lucasd92/modulo_adquisidor/Capturas/Frontal v1-70 print.png

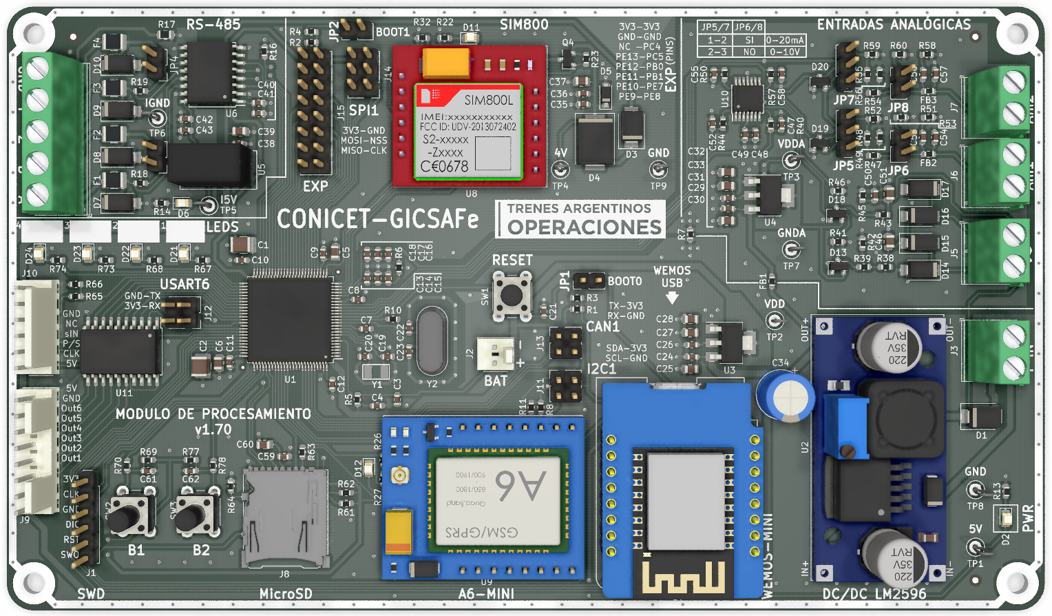
Capturas/Frontal v1-70 print.png
