lucasd92/modulo_adquisidor/Capturas/Perspectiva v1-70 print.png

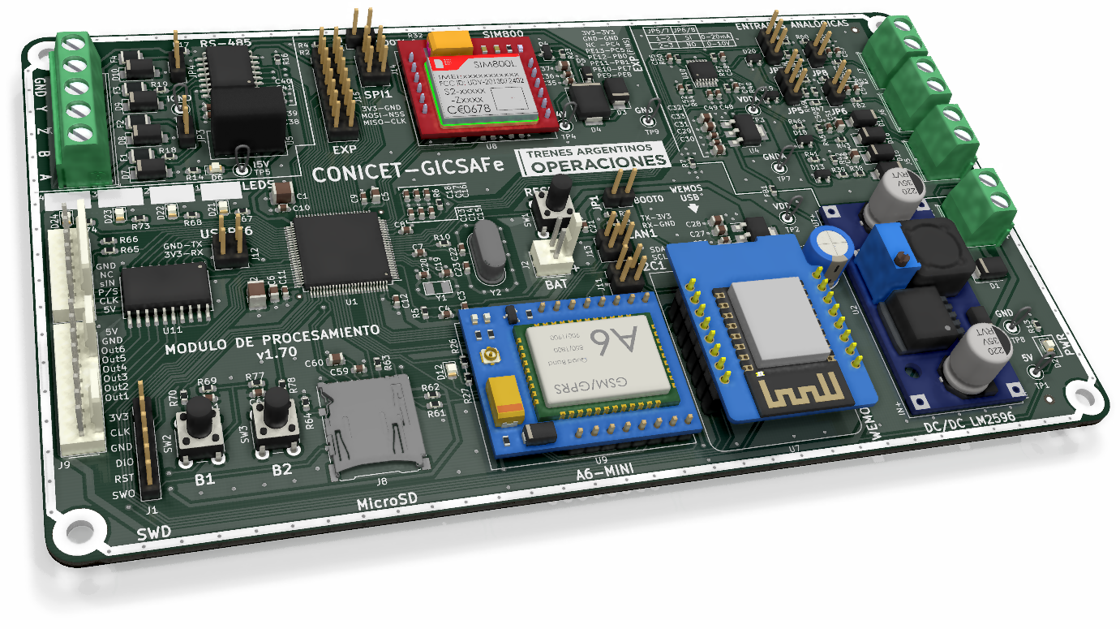
Capturas/Perspectiva v1-70 print.png
