lucasd92/modulo_adquisidor/Capturas/5v.jpg

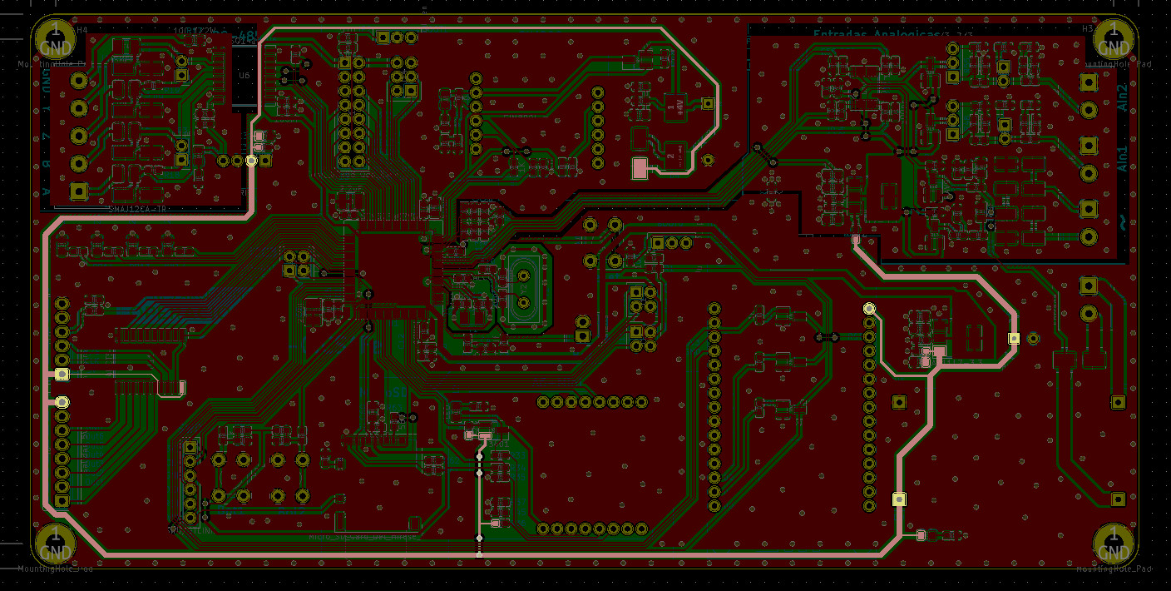
Capturas/5v.jpg
