lucasd92/modulo_adquisidor/Capturas/Frontal v1-61.jpg

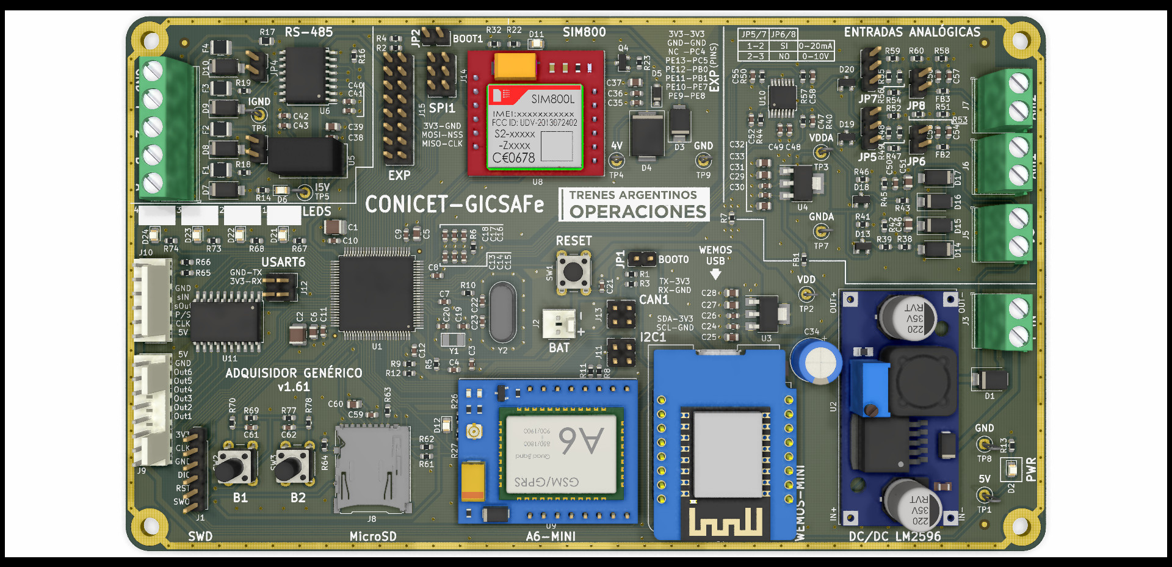
Capturas/Frontal v1-61.jpg
