lucasd92/modulo_adquisidor/Capturas/Trasero v1-1.jpg

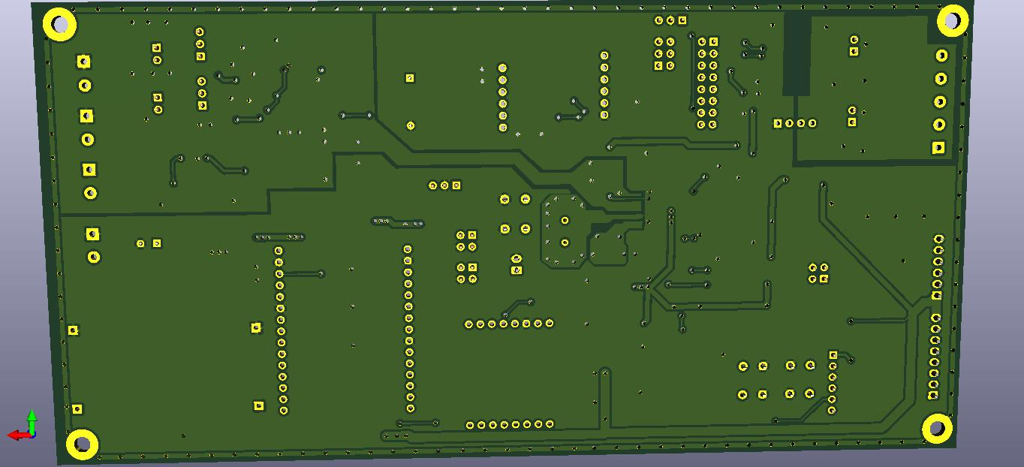
Capturas/Trasero v1-1.jpg
