lucasd92/modulo_adquisidor/Capturas/Trasero v1-3.jpg

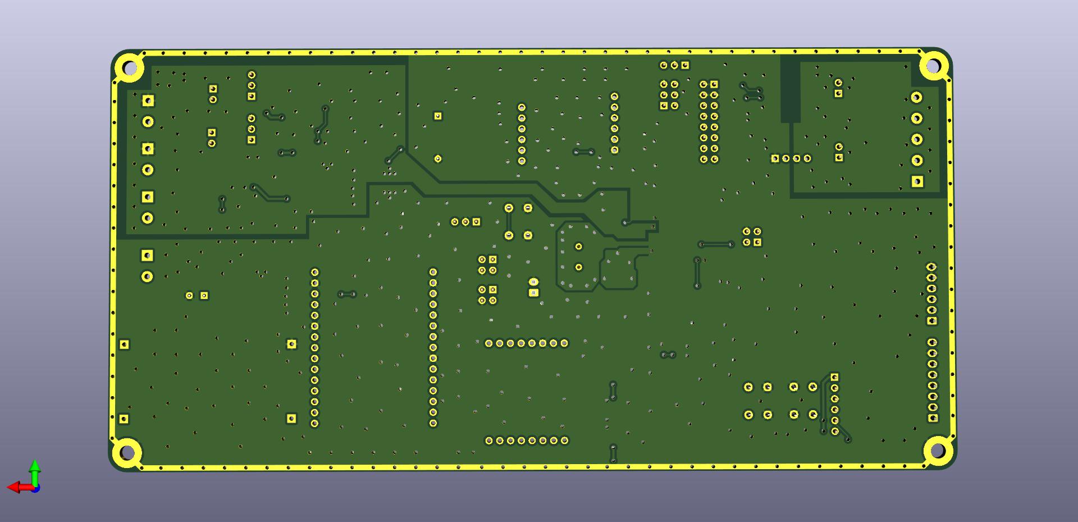
Capturas/Trasero v1-3.jpg
