lucasd92/modulo_adquisidor/Capturas/Trasero v1.jpg

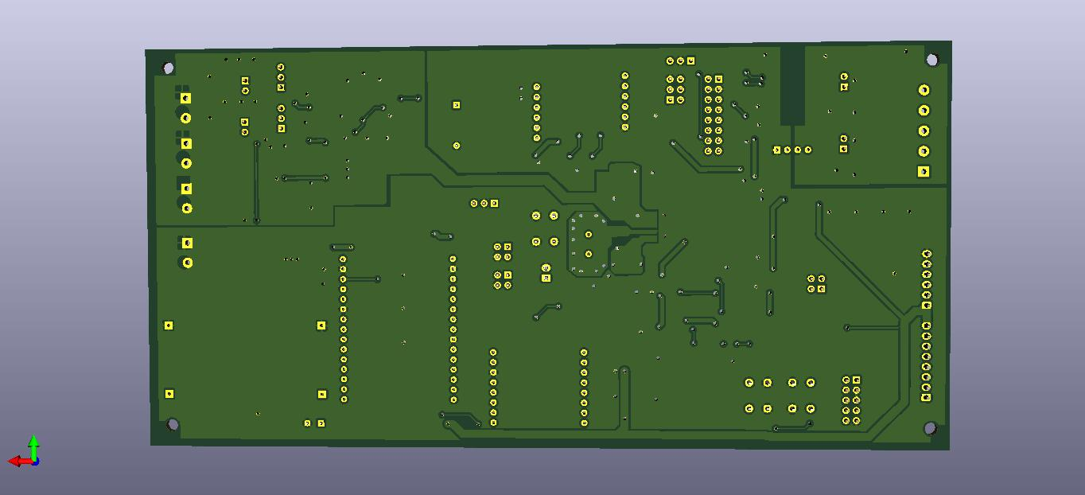
Capturas/Trasero v1.jpg
