lucasd92/modulo_adquisidor/Capturas/vcc.jpg

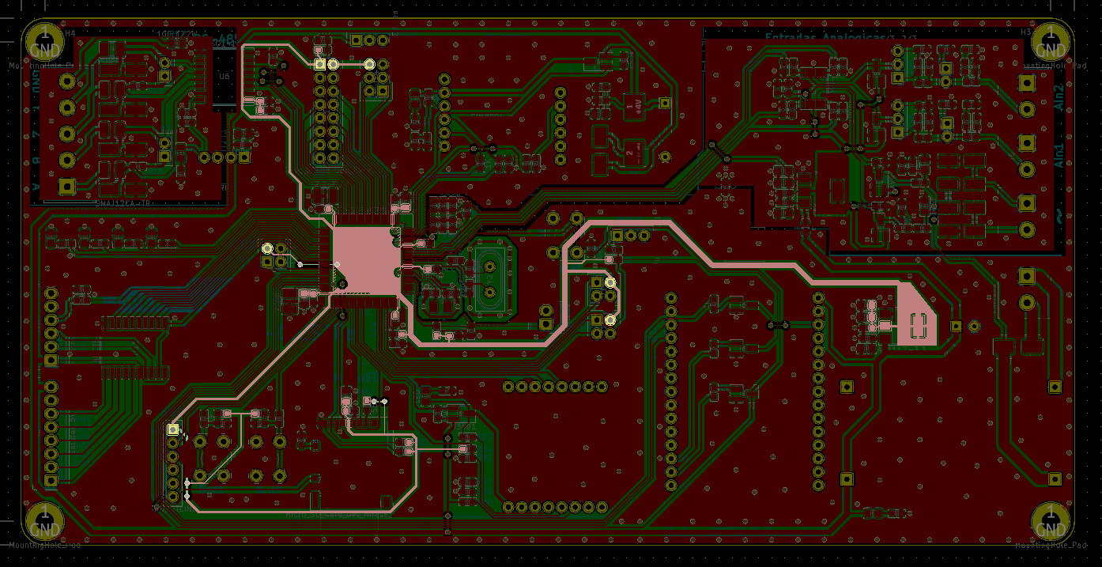
Capturas/vcc.jpg
