lucasd92/modulo_adquisidor/BOM.xlsx

Eeschema (5.0.2)-1
Component Count: | 212
Ref | Qty | Value | Part | Footprint | Column1 | Datasheet | Description | Vendor
C1, C2 | 2 | 2.2uF | C | Capacitor_SMD:C_1210_3225Metric | 478-2402-1-ND | https://www.digikey.com/product-detail/en/avx-corporation/TPSB475K020R1000/478-2402-1-ND/678570 | Unpolarized capacitor
C3, C15, C17, C40, C42, C48 | 6 | 1Uf | C | Capacitor_SMD:C_0603_1608Metric | 1276-1019-1-ND | https://www.digikey.com/product-detail/en/samsung-electro-mechanics/CL10B105KO8NNNC/1276-1019-1-ND/3889105 | Unpolarized capacitor
C4, C7, C8, C9, C10, C11, C12, C14, C16, C21, C24, C26, C29, C31, C38, C41, C43, C44, C45, C47, C49, C50, C52, C55,C58, C59, C61, C62 | 28 | 100nF | C | Capacitor_SMD:C_0603_1608Metric | 1276-1000-1-ND | https://www.digikey.com/product-detail/en/samsung-electro-mechanics/CL10B104KB8NNNC/1276-1000-1-ND/3889086 | Unpolarized capacitor
C5, C6 | 2 | 4.7uF | C | Capacitor_SMD:C_0805_2012Metric | 445-14527-1-ND | https://www.digikey.com/product-detail/en/tdk-corporation/C2012X7R1A475K085AC/445-14527-1-ND/3956193 | Unpolarized capacitor
C13, C18 | 2 | 10nF | C | Capacitor_SMD:C_0603_1608Metric | 1276-1009-1-ND | https://www.digikey.com/product-detail/en/samsung-electro-mechanics/CL10B103KB8NNNC/1276-1009-1-ND/3889095 | Unpolarized capacitor
C19, C20 | 2 | 1.5pF | C | Capacitor_SMD:C_0603_1608Metric | 311-1737-1-ND | https://www.digikey.com/product-detail/es/yageo/CC0603BRNPO9BN1R5/311-1737-1-ND/5195639 | Unpolarized capacitor
C22, C23 | 2 | 20pF | C | Capacitor_SMD:C_0603_1608Metric | 311-3924-1-ND | https://www.digikey.com/product-detail/en/yageo/CC0603GRNPO9BN200/311-3924-1-ND/8025013 | Unpolarized capacitor
C25, C27, C28, C30, C32, C33, C37, C39, C46, C51, C60 | 11 | 10uF | C | Capacitor_SMD:C_0805_2012Metric | 490-10498-1-ND | https://www.digikey.com/product-detail/en/murata-electronics-north-america/GRM21BC81C106KE15L/490-10498-1-ND/5026423 | Unpolarized capacitor
C34 | 1 | 820uF 10V | CP | Capacitor_THT:CP_Radial_D8.0mm_P3.50mm | 399-14115-ND | https://www.digikey.com/product-detail/en/kemet/A755KS827M1AAAE014/399-14115-ND/6196460 | Polarized capacitor
C35 | 1 | 10p | C | Capacitor_SMD:C_0603_1608Metric | 732-7760-1-ND | https://www.digikey.com/product-detail/en/wurth-electronics-inc/885012006017/732-7760-1-ND/5454387 | Unpolarized capacitor
C36 | 1 | 33p | C | Capacitor_SMD:C_0603_1608Metric | 478-10278-1-ND | https://www.digikey.com/product-detail/en/avx-corporation/06033A330JAT2A/478-10278-1-ND/6797495 | Unpolarized capacitor
C53, C56 | 2 | 470pF | C | Capacitor_SMD:C_0603_1608Metric | 1276-1094-1-ND | https://www.digikey.com/product-detail/en/samsung-electro-mechanics/CL10B471KB8NNNC/1276-1094-1-ND/3889180 | Unpolarized capacitor
C54, C57 | 2 | 1nF | C | Capacitor_SMD:C_0603_1608Metric | 1276-1018-1-ND | https://www.digikey.com/product-detail/en/samsung-electro-mechanics/CL10B102KB8NNNC/1276-1018-1-ND/3889104 | Unpolarized capacitor
D1, D3 | 2 | S5JB-R5G | 1N4007 | Diode_SMD:D_SMB | S5JBR5GCT-ND | https://www.digikey.com/product-detail/en/taiwan-semiconductor-corporation/S5JB-R5G/S5JBR5GCT-ND/7358545 | 1000V 1A General Purpose Rectifier Diode, DO-41
D2, D6, D11, D12, D21, D22, D23, D24 | 8 | LED | LED | LED_SMD:LED_0805_2012Metric |  | ~ | Light emitting diode
D4 | 1 | B340 | B340 | Diode_SMD:D_SMC | B340-FDICT-ND | https://www.digikey.com/product-detail/en/diodes-incorporated/B340-13-F/B340-FDICT-ND/768811 | 40V 3A Schottky Barrier Rectifier Diode, SMC
D5 | 1 | BZT52-B5V1X | ZPDxx | Diode_SMD:D_SOD-123 | 1727-7681-1-ND | https://www.digikey.com/product-detail/en/nexperia-usa-inc/BZT52-B5V1X/1727-7681-1-ND/8640662 | 500mW Zener Diode, DO-35
D7, D8, D9, D10 | 4 | SMAJ12CA-TR | D_TVS | Diode_SMD:D_SMA | 497-2996-1-ND | https://www.digikey.com/product-detail/en/stmicroelectronics/SMAJ12CA-TR/497-2996-1-ND/634854 | Bidirectional transient-voltage-suppression diode
D13, D18, D19, D20 | 4 | BAV99 | BAV99 | Package_TO_SOT_SMD:SOT-23 | BAV99LT1GOSCT-ND | https://www.digikey.com/product-detail/en/on-semiconductor/BAV99LT1G/BAV99LT1GOSCT-ND/917821 | BAV99 High-speed switching diodes
D14, D15, D16, D17 | 4 | MRA4007T3G | MRA4007T3G | Diode_SMD:D_SMA | 641-1018-1-ND | https://www.digikey.com/product-detail/en/comchip-technology/CGRA4007-G/641-1018-1-ND/1121140 | 1000V 1A General Purpose Rectifier Diode, SMA(DO-214AC)
F1, F2, F3, F4 | 4 | USMF020 | Fuse | Resistor_SMD:R_1210_3225Metric | MF-USMF020-2CT-ND | https://www.digikey.com/product-detail/es/bourns-inc/MF-USMF020-2/MF-USMF020-2CT-ND/1014928 | Fuse
FB1 | 1 | Ferrite_Bead | Ferrite_Bead | Resistor_SMD:R_0603_1608Metric | 445-2205-1-ND | https://www.digikey.com/product-detail/en/tdk-corporation/MPZ1608S601ATA00/445-2205-1-ND/765103 | Ferrite bead
FB2, FB3 | 2 | MMZ1608B601C | Ferrite_Bead_Small | Resistor_SMD:R_0603_1608Metric | 445-2166-1-ND | https://www.digikey.com/product-detail/en/tdk-corporation/MMZ1608B601CTAH0/445-2166-1-ND/765197 | Ferrite bead, small symbol
J1 | 1 | SWD/STLINK | Conn_01x06_Male | Connector_PinHeader_2.54mm:PinHeader_1x06_P2.54mm_Vertical |  | ~
J2 | 1 | Bateria | Conn_01x02_Male | Connector_Molex:Molex_KK-254_AE-6410-02A_1x02_P2.54mm_Vertical |  | ~
J3 | 1 | Entrada 24V | Screw_Terminal_01x02 | Propios:TerminalBlock_Phoenix_PT-1,5-2-5.0-H_1x02_P5.00mm_Horizontal_con_modelo3d |  | ~
J4 | 1 | RS-485 | Screw_Terminal_01x05 | Propios:TerminalBlock_Phoenix_PT-1,5-5-5.0-H_1x05_P5.00mm_Horizontal_con_modelo3d |  | ~
J5 | 1 | TV_6V | Screw_Terminal_01x02 | Propios:TerminalBlock_Phoenix_PT-1,5-2-5.0-H_1x02_P5.00mm_Horizontal_con_modelo3d |  | ~
J6 | 1 | AN1 | Screw_Terminal_01x02 | Propios:TerminalBlock_Phoenix_PT-1,5-2-5.0-H_1x02_P5.00mm_Horizontal_con_modelo3d |  | ~
J7 | 1 | AN2 | Screw_Terminal_01x02 | Propios:TerminalBlock_Phoenix_PT-1,5-2-5.0-H_1x02_P5.00mm_Horizontal_con_modelo3d |  | ~
J8 | 1 | Micro_SD | Micro_SD_Card_Det_Hirose_DM3AT | Propios:microSD_HC_Hirose_DM3AT-SF-PEJM5 | HR1964CT-ND | https://www.digikey.com/product-detail/es/hirose-electric-co-ltd/DM3AT-SF-PEJM5/HR1964CT-ND/2533566
J9 | 1 | Salidas 5V | Conn_01x08_Male | Connector_Molex:Molex_KK-254_AE-6410-08A_1x08_P2.54mm_Vertical |  | ~
J10 | 1 | entradas digitales | Conn_01x06_Male | Connector_Molex:Molex_KK-254_AE-6410-06A_1x06_P2.54mm_Vertical |  | ~
J11 | 1 | I2C1 | Conn_02x02_Odd_Even | Connector_PinHeader_2.54mm:PinHeader_2x02_P2.54mm_Vertical |  | ~
J12 | 1 | USART6 | Conn_02x02_Odd_Even | Connector_PinHeader_2.54mm:PinHeader_2x02_P2.54mm_Vertical |  | ~
J13 | 1 | CAN1 | Conn_02x02_Odd_Even | Connector_PinHeader_2.54mm:PinHeader_2x02_P2.54mm_Vertical |  | ~
J14 | 1 | SPI1 | Conn_02x03_Odd_Even | Connector_PinHeader_2.54mm:PinHeader_2x03_P2.54mm_Vertical |  | ~
J15 | 1 | Conn_02x08_Odd_Even | Conn_02x08_Odd_Even | Connector_PinHeader_2.54mm:PinHeader_2x08_P2.54mm_Vertical |  | ~
JP1, JP2 | 2 | Jumper_2_Open | Jumper_2_Open | Connector_PinHeader_2.54mm:PinHeader_1x02_P2.54mm_Vertical |  | ~ | Jumper, 2-pole, open
JP3, JP4 | 2 | Jumper | Jumper | Connector_PinHeader_2.54mm:PinHeader_1x02_P2.54mm_Vertical |  | ~ | Jumper, normally closed
JP5, JP7 | 2 | 1/3-2/3 | Jumper_3_Open | Connector_PinHeader_2.54mm:PinHeader_1x03_P2.54mm_Vertical |  | ~ | Jumper, 3-pole, both open
JP6, JP8 | 2 | I_meas | Jumper | Connector_PinHeader_2.54mm:PinHeader_1x02_P2.54mm_Vertical |  | ~ | Jumper, normally closed
Q1, Q2, Q3 | 3 | MMBT3904 | MMBT3904 | Package_TO_SOT_SMD:SOT-23 | MMBT3904TPMSCT-ND | https://www.digikey.com/product-detail/en/micro-commercial-co/MMBT3904-TP/MMBT3904TPMSCT-ND/717395 | 0.2A Ic, 40V Vce, Small Signal NPN Transistor, SOT-23
Q4, Q5 | 2 | AO3401 | BSS83P | Package_TO_SOT_SMD:SOT-23 | 785-1001-1-ND | https://www.digikey.com/product-detail/en/alpha-omega-semiconductor-inc/AO3401A/785-1001-1-ND/1855943 | -0.33A Id, -60V Vds, P-Channel MOSFET, SOT-23-3
R1, R2,R69, R77 | 4 | 10K | R | Resistor_SMD:R_0603_1608Metric | RMCF0603FT10K0CT-ND | https://www.digikey.com/product-detail/en/stackpole-electronics-inc/RMCF0603FT10K0/RMCF0603FT10K0CT-ND/1943057 | Resistor
R3, R4 | 2 | 510 | R | Resistor_SMD:R_0603_1608Metric | RMCF0603FT510RCT-ND | https://www.digikey.com/product-detail/en/stackpole-electronics-inc/RMCF0603FT510R/RMCF0603FT510RCT-ND/2418081 | Resistor
R5, R7, R9, R12, R28, R32, R33, R34, R35, R36, R37, R42, R45, R49, R56, R64 | 17 | 0 | R | Resistor_SMD:R_0603_1608Metric | RMCF0603ZT0R00CT-ND | https://www.digikey.com/product-detail/en/stackpole-electronics-inc/RMCF0603ZT0R00/RMCF0603ZT0R00CT-ND/1943218 | Resistor
R6 | 1 | 47 | R | Resistor_SMD:R_0603_1608Metric | RMCF0603FT47R0CT-ND | https://www.digikey.com/product-detail/en/stackpole-electronics-inc/RMCF0603FT47R0/RMCF0603FT47R0CT-ND/1942954 | Resistor
R8, R11 | 2 | 4K7 | R | Resistor_SMD:R_0603_1608Metric | RMCF0603FT4K70CT-ND | https://www.digikey.com/product-detail/en/stackpole-electronics-inc/RMCF0603FT4K70/RMCF0603FT4K70CT-ND/1943033 | Resistor
R10 | 0 | CALCULAR | R | Resistor_SMD:R_0603_1608Metric |  | ~ | Resistor
R15, R20, R21, R24, R25, R29,R13, R14, R22,R27,R70, R78 | 12 | 1K | R | Resistor_SMD:R_0603_1608Metric | RMCF0603FT1K00CT-ND | https://www.digikey.com/product-detail/en/stackpole-electronics-inc/RMCF0603FT1K00/RMCF0603FT1K00CT-ND/1942996 | Resistor
R16, R30, R31 | 3 | 5K6 | R | Resistor_SMD:R_0603_1608Metric | RMCF0603FT5K60CT-ND | https://www.digikey.com/product-detail/en/stackpole-electronics-inc/RMCF0603FT5K60/RMCF0603FT5K60CT-ND/2418099 | Resistor
R17 | 1 | 100 1/2W | R | Resistor_SMD:R_0805_2012Metric | P100ADCT-ND | https://www.digikey.com/product-detail/en/panasonic-electronic-components/ERJ-P06J101V/P100ADCT-ND/525436 | Resistor
R18, R19 | 2 | 120 | R | Resistor_SMD:R_0603_1608Metric | RMCF0603FT120RCT-ND | https://www.digikey.com/product-detail/en/stackpole-electronics-inc/RMCF0603FT120R/RMCF0603FT120RCT-ND/1942967 | Resistor
R23, R26 | 2 | 150k | R | Resistor_SMD:R_0603_1608Metric | RMCF0603FT150KCT-ND | https://www.digikey.com/product-detail/en/stackpole-electronics-inc/RMCF0603FT150K/RMCF0603FT150KCT-ND/1943124 | Resistor
R38, R39, R41, R47, R48, R52, R54, R55, R59 | 9 | 15k | R | Resistor_SMD:R_0603_1608Metric | RMCF0603FG15K0CT-ND | https://www.digikey.com/product-detail/en/stackpole-electronics-inc/RMCF0603FG15K0/RMCF0603FG15K0CT-ND/4425035 | Resistor
R40, R44, R50, R57 | 4 | 1.5k | R | Resistor_SMD:R_0603_1608Metric | RMCF0603FT1K50CT-ND | https://www.digikey.com/product-detail/en/stackpole-electronics-inc/RMCF0603FT1K50/RMCF0603FT1K50CT-ND/1943003 | Resistor
R43 | 1 | 47k | R | Resistor_SMD:R_0603_1608Metric | RMCF0603FT47K0CT-ND | https://www.digikey.com/product-detail/en/stackpole-electronics-inc/RMCF0603FT47K0/RMCF0603FT47K0CT-ND/1943099 | Resistor
R46 | 1 | 12k | R | Resistor_SMD:R_0603_1608Metric | RMCF0603FT12K0CT-ND | https://www.digikey.com/product-detail/en/stackpole-electronics-inc/RMCF0603FT12K0/RMCF0603FT12K0CT-ND/1943062 | Resistor
R51, R58 | 2 | 4.7 | R | Resistor_SMD:R_0603_1608Metric | 2019-RK73H1JTTD4R70FCT-ND | https://www.digikey.com/product-detail/en/koa-speer-electronics-inc/RK73H1JTTD4R70F/2019-RK73H1JTTD4R70FCT-ND/9846919 | Resistor
R53, R60, R65 | 3 | 220 | R | Resistor_SMD:R_0603_1608Metric | RMCF0603FT220RCT-ND | https://www.digikey.com/product-detail/en/stackpole-electronics-inc/RMCF0603FT220R/RMCF0603FT220RCT-ND/1942973 | Resistor
R61, R62, R63 | 3 | 56K | R | Resistor_SMD:R_0603_1608Metric | RMCF0603FT56K0CT-ND | https://www.digikey.com/product-detail/en/stackpole-electronics-inc/RMCF0603FT56K0/RMCF0603FT56K0CT-ND/2418092 | Resistor
R66 | 1 | 330 | R | Resistor_SMD:R_0603_1608Metric | RMCF0603FT330RCT-ND | https://www.digikey.com/product-detail/en/stackpole-electronics-inc/RMCF0603FT330R/RMCF0603FT330RCT-ND/1942981 | Resistor
R67, R68, R73, R74 | 4 | 260 | R | Resistor_SMD:R_0603_1608Metric | RMCF0603FT261RCT-ND | https://www.digikey.com/product-detail/en/stackpole-electronics-inc/RMCF0603FT261R/RMCF0603FT261RCT-ND/2417998 | Resistor
SW1, SW2, SW3 | 3 | SW_Push | SW_Push | Button_Switch_THT:SW_PUSH_6mm_H9.5mm |  |  | Push button switch, generic, two pins
U1 | 1 | STM32F407VGTx | STM32F407VGTx | Package_QFP:LQFP-100_14x14mm_P0.5mm | 497-11605-ND | https://www.digikey.com/product-detail/en/stmicroelectronics/STM32F407VGT6/497-11605-ND/2747117 | ARM Cortex-M4 MCU, 1024KB flash, 128KB RAM, 168MHz, 1.8-3.6V, 82 GPIO, LQFP-100
U2 | 1 | DC-DC_Step-Down | DC-DC_Step-Down | Propios:modulo_dc-dc-LM2596 |  | http://www.ti.com/lit/ds/symlink/lm2596.pdf | Basado en LM2596
U3, U4 | 2 | AZ1117-3.3 | AZ1117-3.3 | Package_TO_SOT_SMD:SOT-223-3_TabPin2 | AZ1117IH-3.3TRG1DICT-ND | https://www.digikey.com/product-detail/en/diodes-incorporated/AZ1117IH-3.3TRG1/AZ1117IH-3.3TRG1DICT-ND/5699682 | 1A 20V Fixed LDO Linear Regulator, 3.3V, SOT-89/SOT-223/TO-220/TO-252/TO-263
U5 | 1 | RFM-0505S | RFM-0505S | Propios:SIP4-RFM0505S | 945-3159-ND | https://www.digikey.com/product-detail/en/recom-power/RFM-0505S/945-3159-ND/8550767
U6 | 1 | ISO1412 | ISO1412 | Package_SO:SOIC-16W_7.5x10.3mm_P1.27mm | 296-53077-ND | https://www.digikey.com/product-detail/en/texas-instruments/ISO1412BDW/296-53077-ND/9860888
U7 | 1 | WeMos_mini | WeMos_mini | wemos:wemos-d1-mini-with-pin-header-and-connector |  | http://www.wemos.cc/Products/d1_mini.html | WeMos D1 mini
U8 | 1 | SIM800L_modulo | SIM800L_modulo | Propios:SIM800L_mod |  | http://mt-system.ru/sites/default/files/documents/sim800_hardware_design_v1.09.pdf | Módulo basado en sim80L de 12 pines
U9 | 1 | Modulo_A6_Mini | Modulo_A6_Mini | Propios:Modulo_A6_mini |  | https://www.makerfabs.com/desfile/files/A6_A7_A6C_datasheet-EN.pdf
U10 | 1 | MCP6L04T-E/ST | LMV324 | Package_SO:TSSOP-14_4.4x5mm_P0.65mm | MCP6L04T-E-STCT-ND | https://www.digikey.com/product-detail/en/microchip-technology/MCP6L04T-E-ST/MCP6L04T-E-STCT-ND/2060123 | Quad Low-Voltage Rail-to-Rail Output Operational Amplifier, SOIC-14/SSOP-14
U11 | 1 | 74HCT541 | 74HCT541 | Package_SO:SOIC-20W_7.5x12.8mm_P1.27mm | 296-14870-1-ND | https://www.digikey.com/product-detail/en/texas-instruments/SN74HCT541DWR/296-14870-1-ND/562554 | 8-bit Buffer/Line Driver 3-state outputs
Y1 | 1 | 32.768KHz | Crystal | Propios:Cristal 32KHz | XC2158CT-ND | https://www.digikey.com/product-detail/es/ecs-inc/ECS-.327-6-34QS-TR/XC2158CT-ND/6050766 | Two pin crystal
Y2 | 1 | 8MHz | Crystal | Crystal:Crystal_HC49-4H_Vertical | 887-1233-ND | https://www.digikey.com/product-detail/en/txc-corporation/9B-8.000MEEJ-B/887-1233-ND/2207653 | Two pin crystal
 | 1 |  | Componente Facundo |  | 828-1058-1-ND | https://www.digikey.com/product-detail/es/bosch-sensortec/BNO055/828-1058-1-ND/6136309
