lucasd92/modulo_adquisidor/3dshapes/ECS-.327-12.5-34B-C-TR--3DModel-STEP-40055.STEP

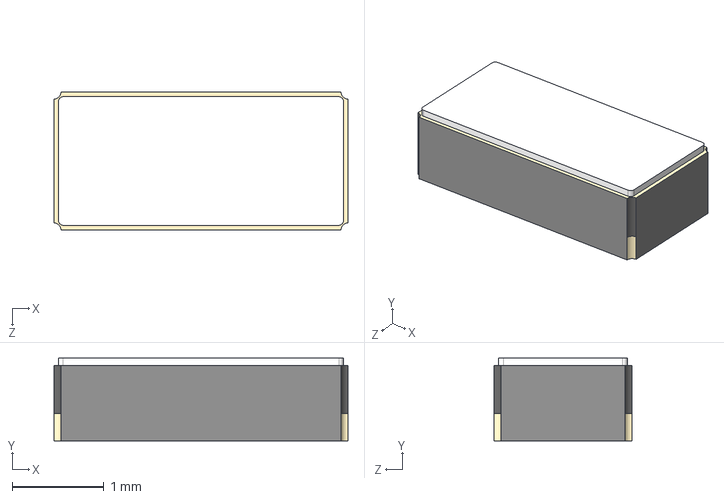
[picture p15: CAD file, 2019-09-19]
3dshapes/ECS-.327-12.5-34B-C-TR--3DModel-STEP-40055.STEP
3.20 x 0.9 x 1.50 mm
