lucasd92/modulo_adquisidor/Placa_base.pdf

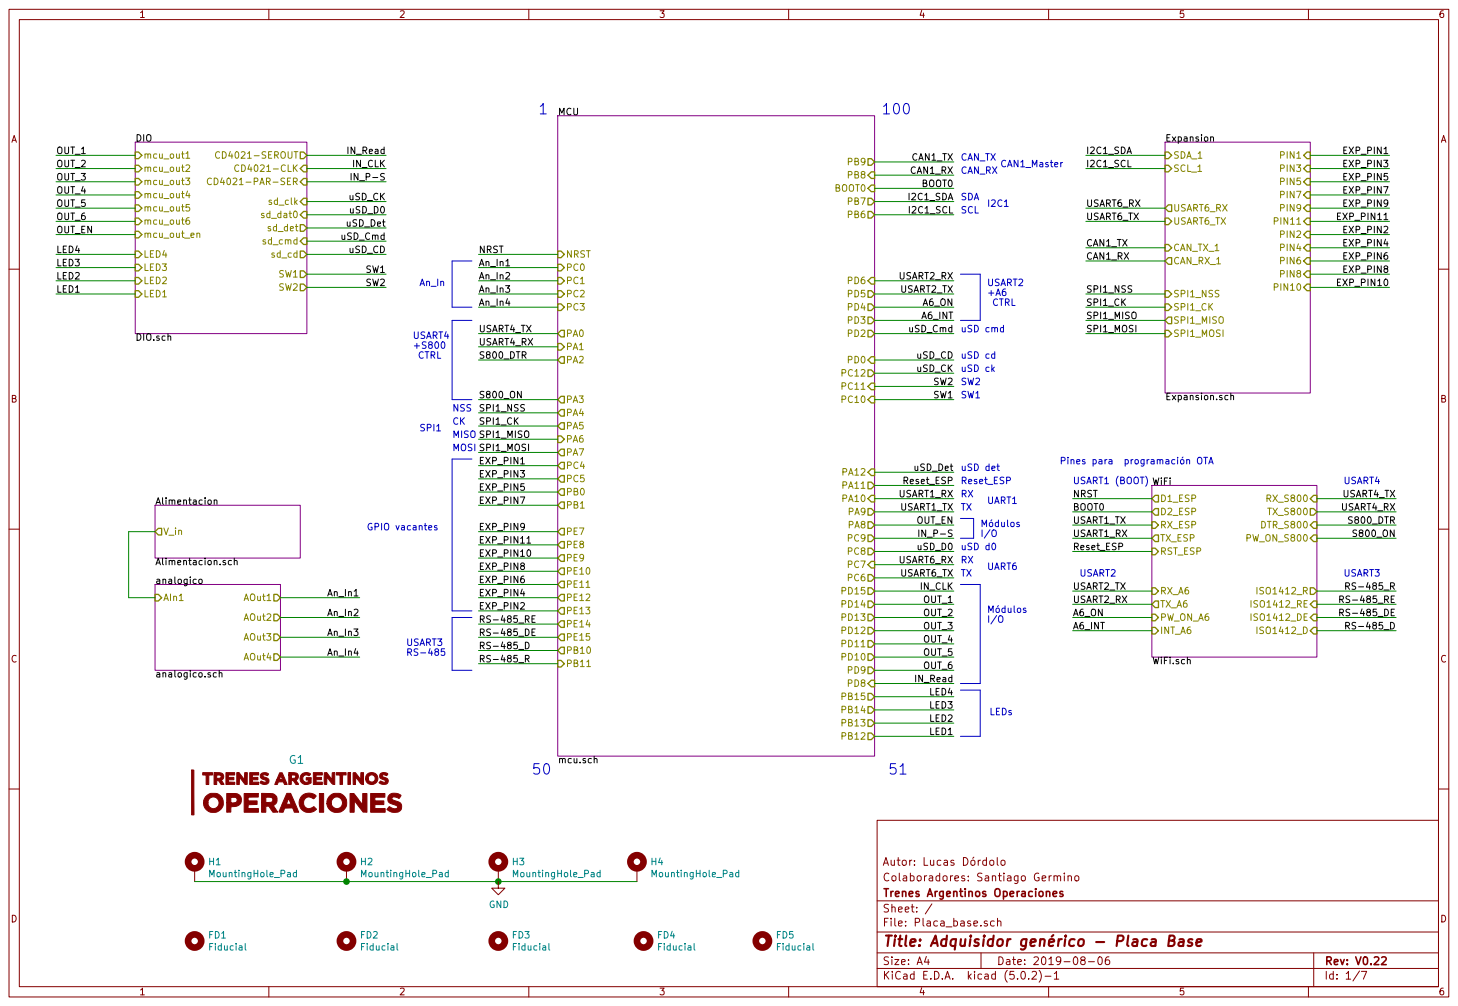
[picture p16: page 1]

A6_INT A6_ON
uSD ck uSD det uSD cd

Colaboradores: Santiago Germino Autor: Lucas Dórdolo

File: Placa_base.sch Sheet: / Trenes Argentinos Operaciones

Id: 1/7 Title: Adquisidor genérico - Placa Base

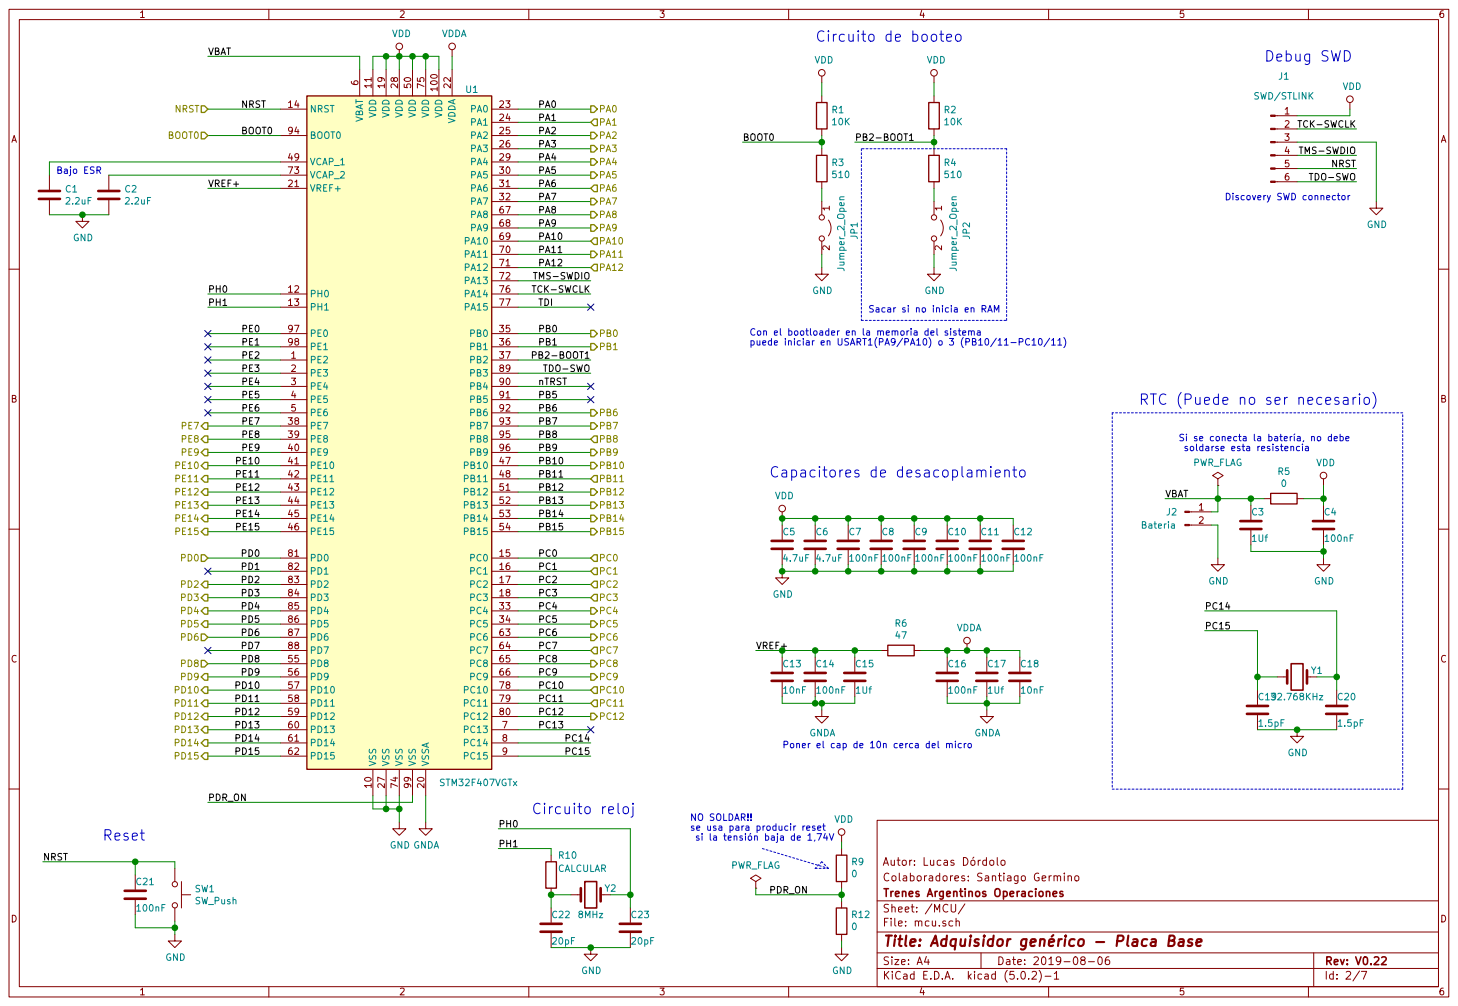
[picture p17: page 2]

nTRST PB5 PB6 PB7 PB8 PB9 TDI PA10 PA11 PA12 TMS-SWDIO
PC15 PC10 PC11 PC12 PC13 PC14 PC0 PC1 PC2 PC3 PC4 PC5 PC6 PC7 PC8 PC9 PB15 PB10 PB11 PB12 PB13 PB14 PB0 PB1 PB2-BOOT1 TDO-SWO

RTC (Puede no ser necesario)

Si se conecta la batería, no debe

10nF Poner el cap de 10n cerca del micro

se usa para producir reset
si la tensión baja de 1,74V

Colaboradores: Santiago Germino Autor: Lucas Dórdolo
File: mcu.sch Sheet: /MCU/ Trenes Argentinos Operaciones
0 GND
Id: 2/7 Title: Adquisidor genérico - Placa Base

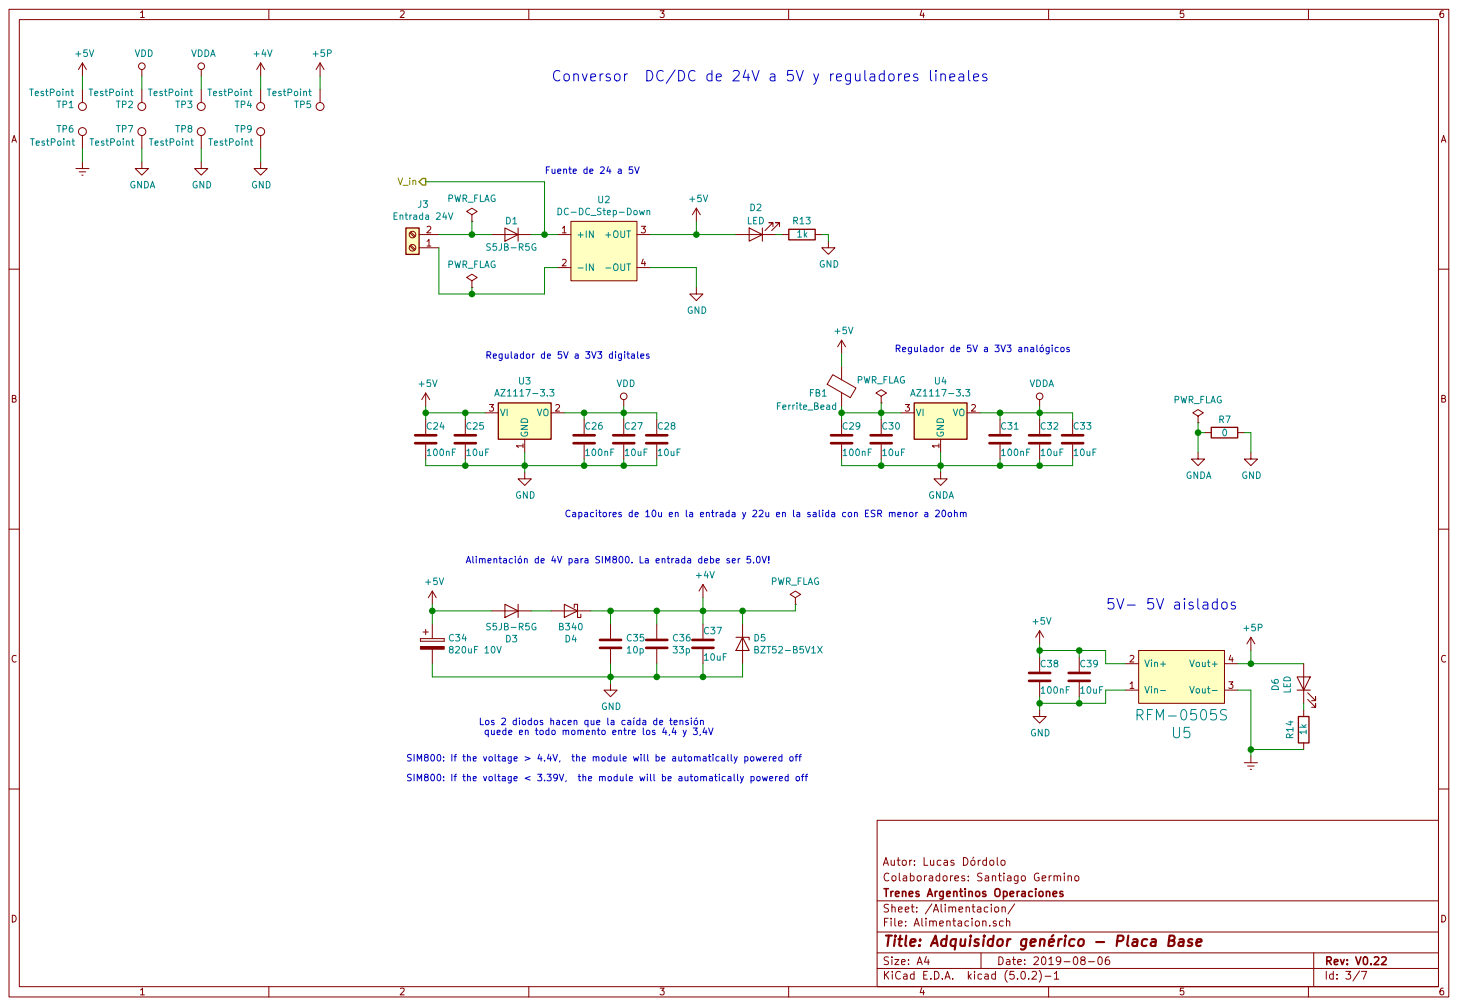
[picture p18: page 3]

Conversor DC/DC de 24V a 5V y reguladores lineales

Colaboradores: Santiago Germino Autor: Lucas Dórdolo GND

10uF SIM800: If the voltage > 4.4V, the module will be automatically powered off

Alimentación de 4V para SIM800. La entrada debe ser 5.0V!

SIM800: If the voltage < 3.39V, the module will be automatically powered off D4 B340 D3 S5JB-R5G

quede en todo momento entre los 4,4 y 3,4V C34

Los 2 diodos hacen que la caída de tensión

File: Alimentacion.sch Sheet: /Alimentacion/ Trenes Argentinos Operaciones

Id: 3/7 Title: Adquisidor genérico - Placa Base

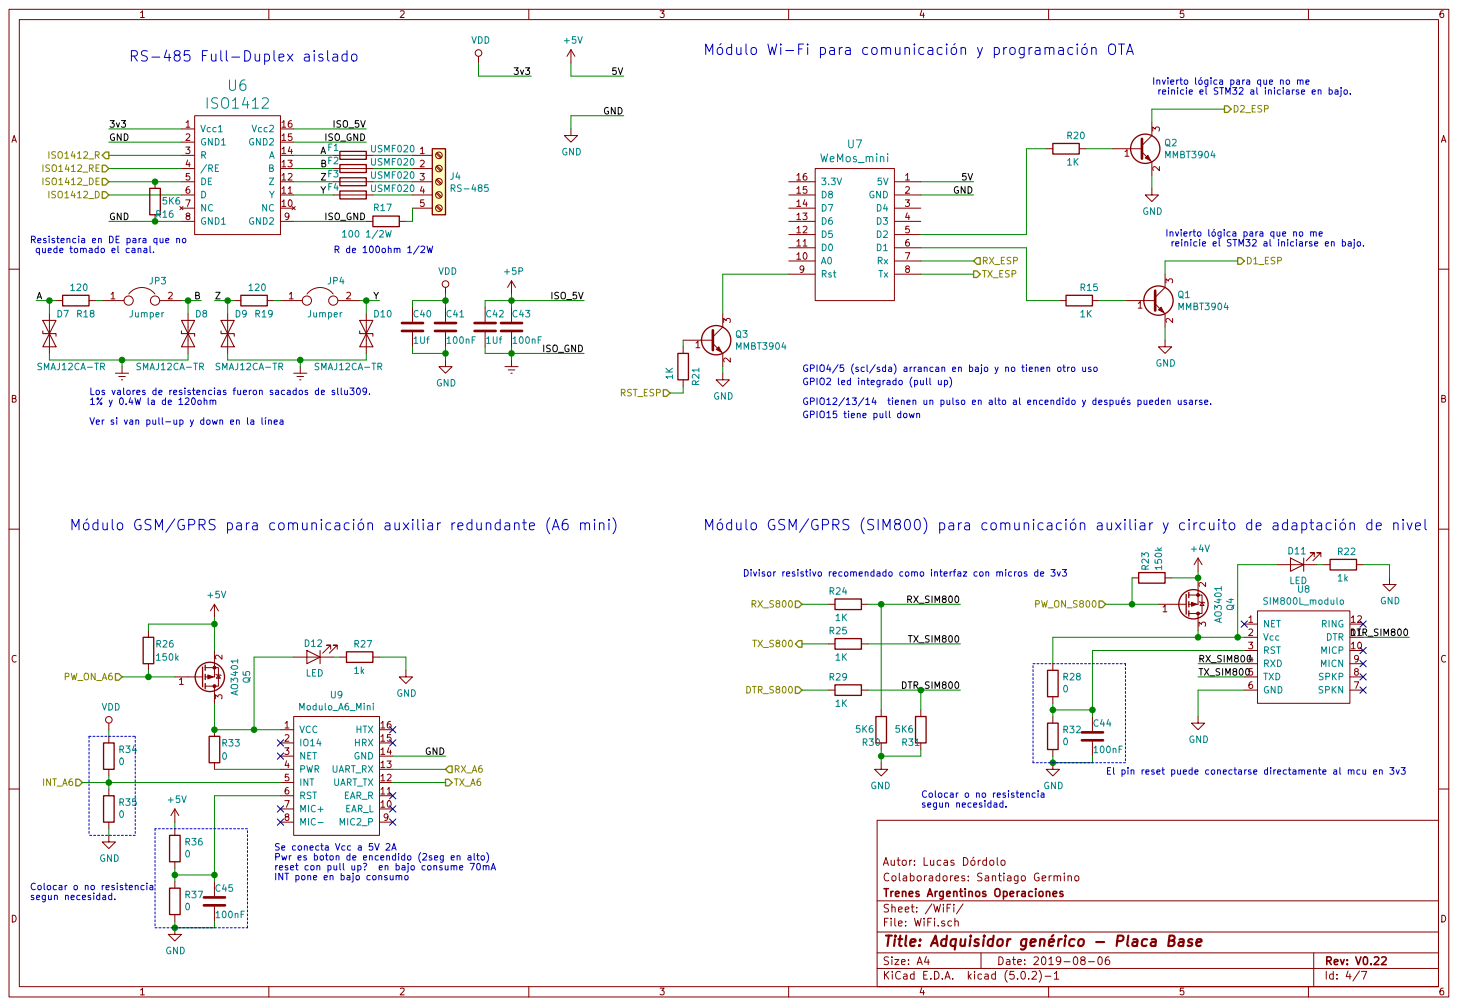
[picture p19: page 4]

RS-485 Full-Duplex aislado

Módulo Wi-Fi para comunicación y programación OTA

Invierto lógica para que no me
reinicie el STM32 al iniciarse en bajo. D1_ESP

GPIO12/13/14 tienen un pulso en alto al encendido y después pueden usarse.1

100 1/2W Resistencia en DE para que no

reinicie el STM32 al iniciarse en bajo.

Módulo GSM/GPRS (SIM800) para comunicación auxiliar y circuito de adaptación de nivel +5PC43

Los valores de resistencias fueron sacados de sllu309. 1% y 0.4W la de 120ohm

GPIO2 led integrado (pull up)

RX_SIM800 TX_SIM800 Divisor resistivo recomendado como interfaz con micros de 3v3

RX_SIM800 TX_SIM800 El pin reset puede conectarse directamente al mcu en 3v3 R24

Pwr es boton de encendido (2seg en alto)
reset con pull up? en bajo consume 70mA

Colaboradores: Santiago Germino Autor: Lucas Dórdolo

File: WiFi.sch Sheet: /WiFi/ Trenes Argentinos Operaciones

Id: 4/7 Title: Adquisidor genérico - Placa Base

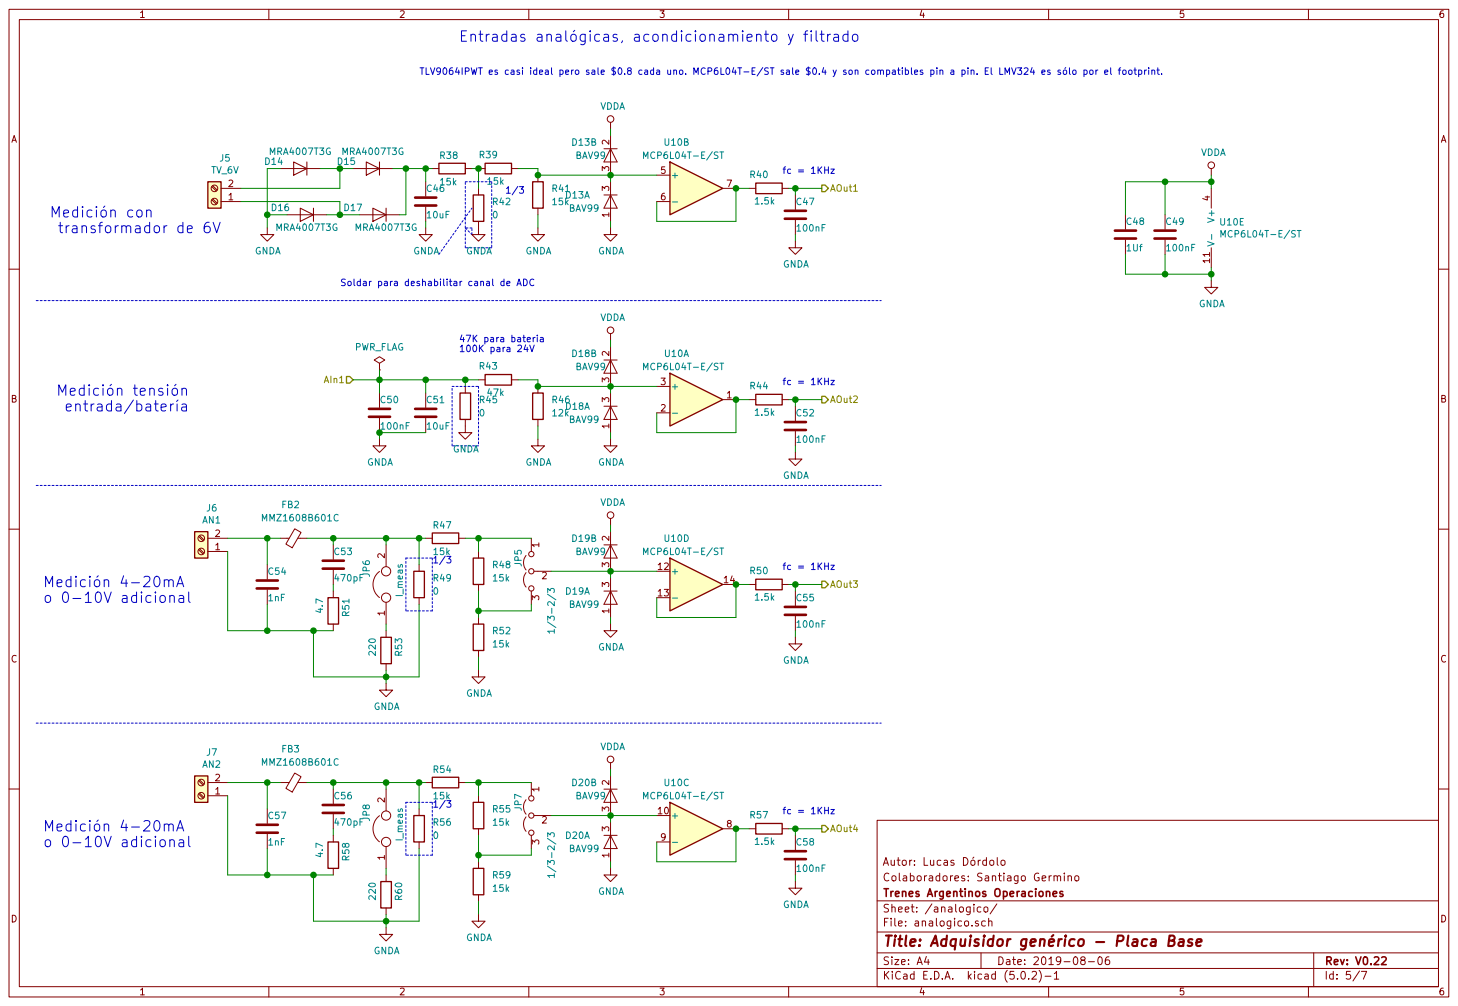
[picture p20: page 5]

Entradas analógicas, acondicionamiento y filtrado

1/3 AIn1
D17MRA4007T3G
0 Soldar para deshabilitar canal de ADC

Colaboradores: Santiago Germino Autor: Lucas Dórdolo

Trenes Argentinos Operaciones
Sheet: /analogico/
File: analogico.sch
Id: 5/7 Title: Adquisidor genérico - Placa Base

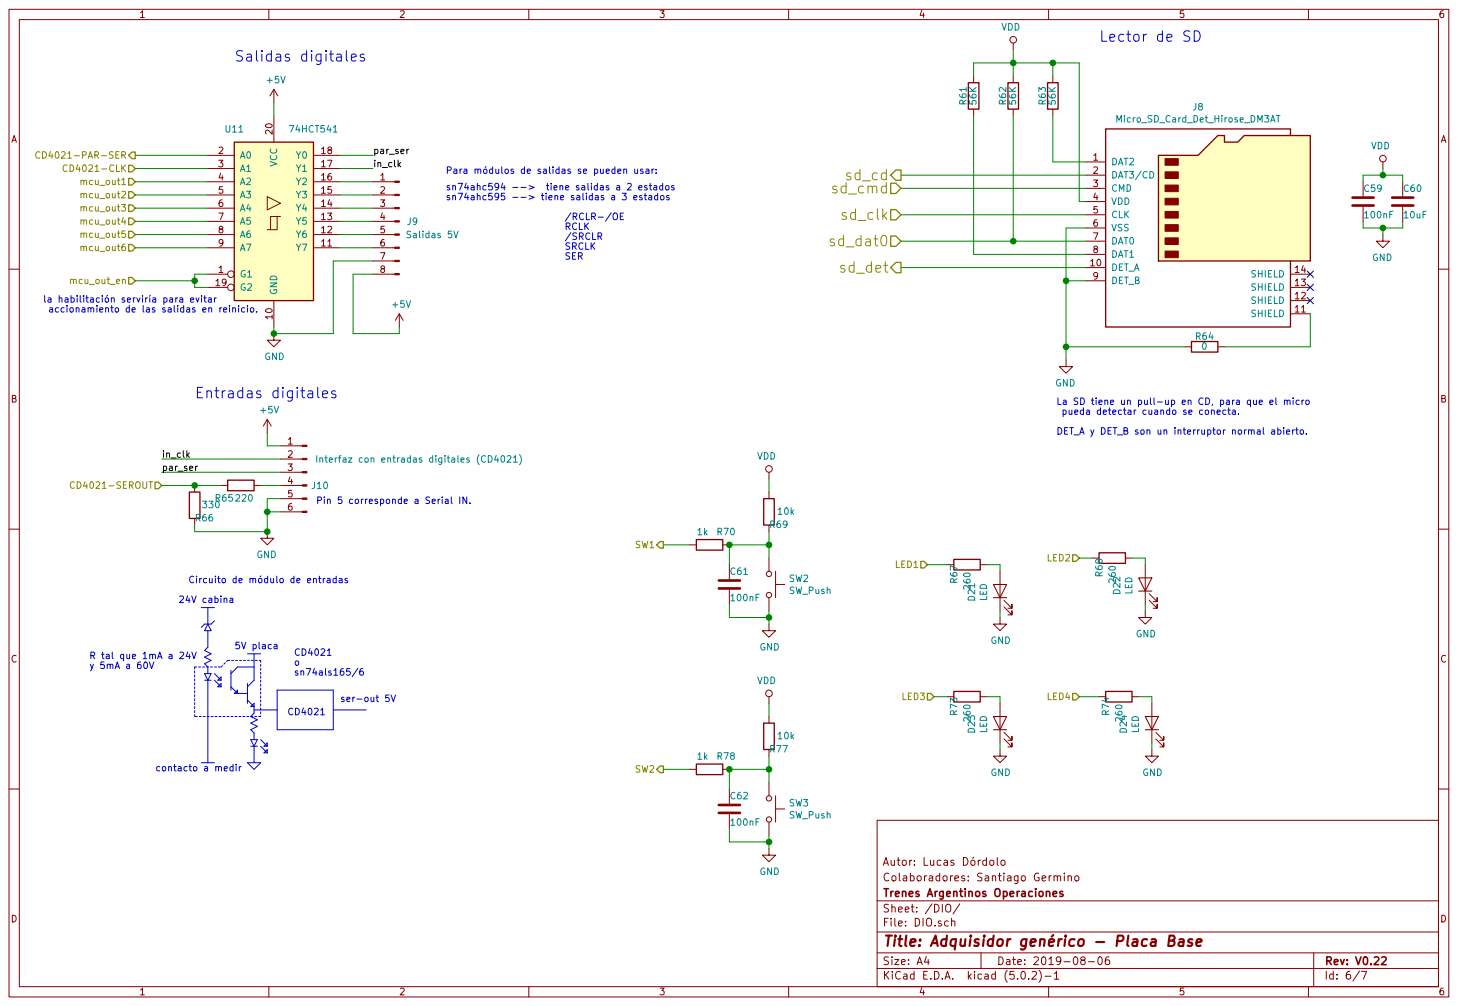
[picture p21: page 6]

10uF VDD GND Lector de SD

sn74ahc595 --> tiene salidas a 3 estados Para módulos de salidas se pueden usar: Circuito de módulo de entradas

la habilitación serviría para evitar
accionamiento de las salidas en reinicio. 24V cabina

La SD tiene un pull-up en CD, para que el micro
pueda detectar cuando se conecta.

Colaboradores: Santiago Germino Autor: Lucas Dórdolo

File: DIO.sch Sheet: /DIO/ Trenes Argentinos Operaciones

Id: 6/7 Title: Adquisidor genérico - Placa Base

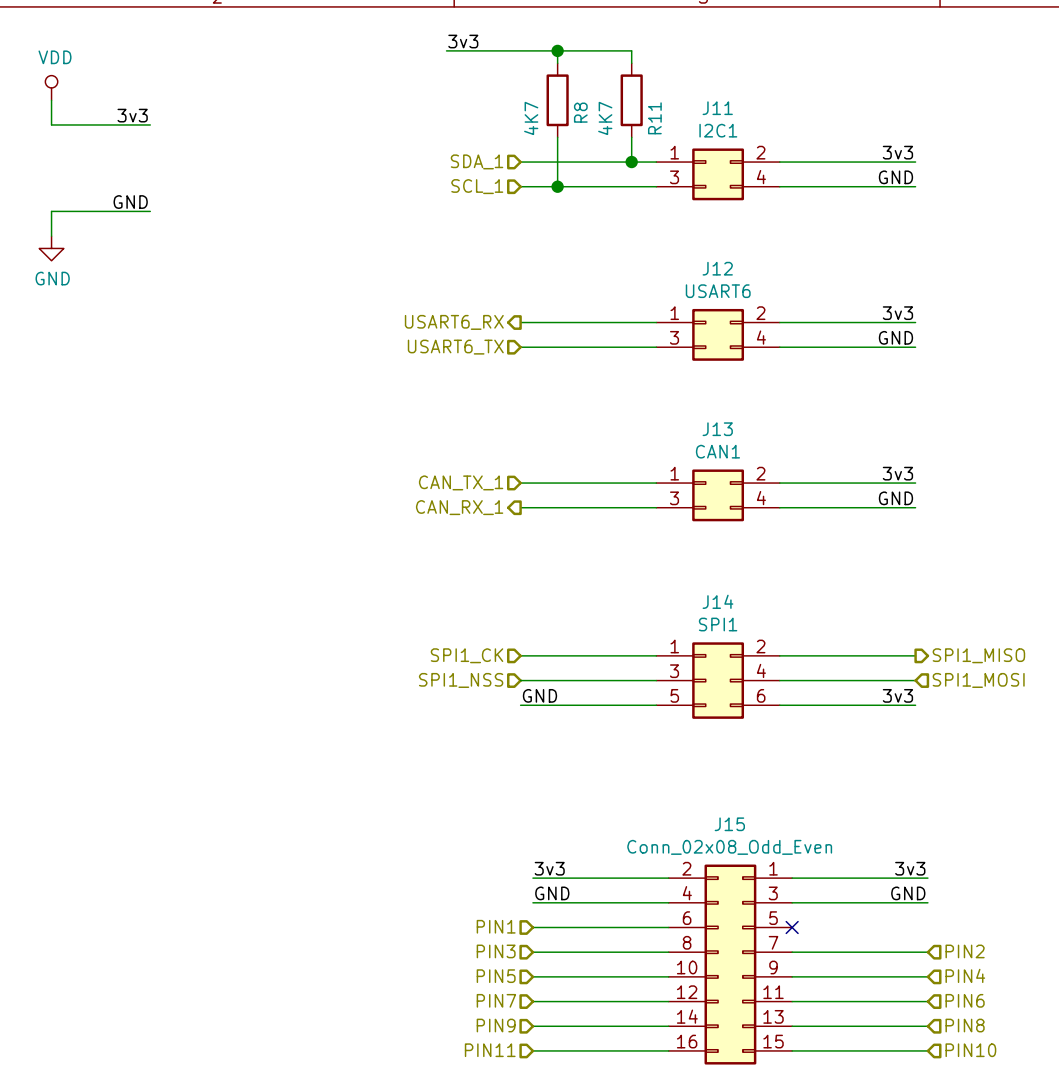
[picture p22: page 7]

Colaboradores: Santiago Germino Autor: Lucas Dórdolo

Trenes Argentinos Operaciones
Sheet: /Expansion/
File: Expansion.sch
Id: 7/7 Title: Adquisidor genérico - Placa Base
