lucasd92/modulo_adquisidor/Placa_base.kicad_pcb

## KiCad design Placa_base.kicad_pcb (2019-09-19)

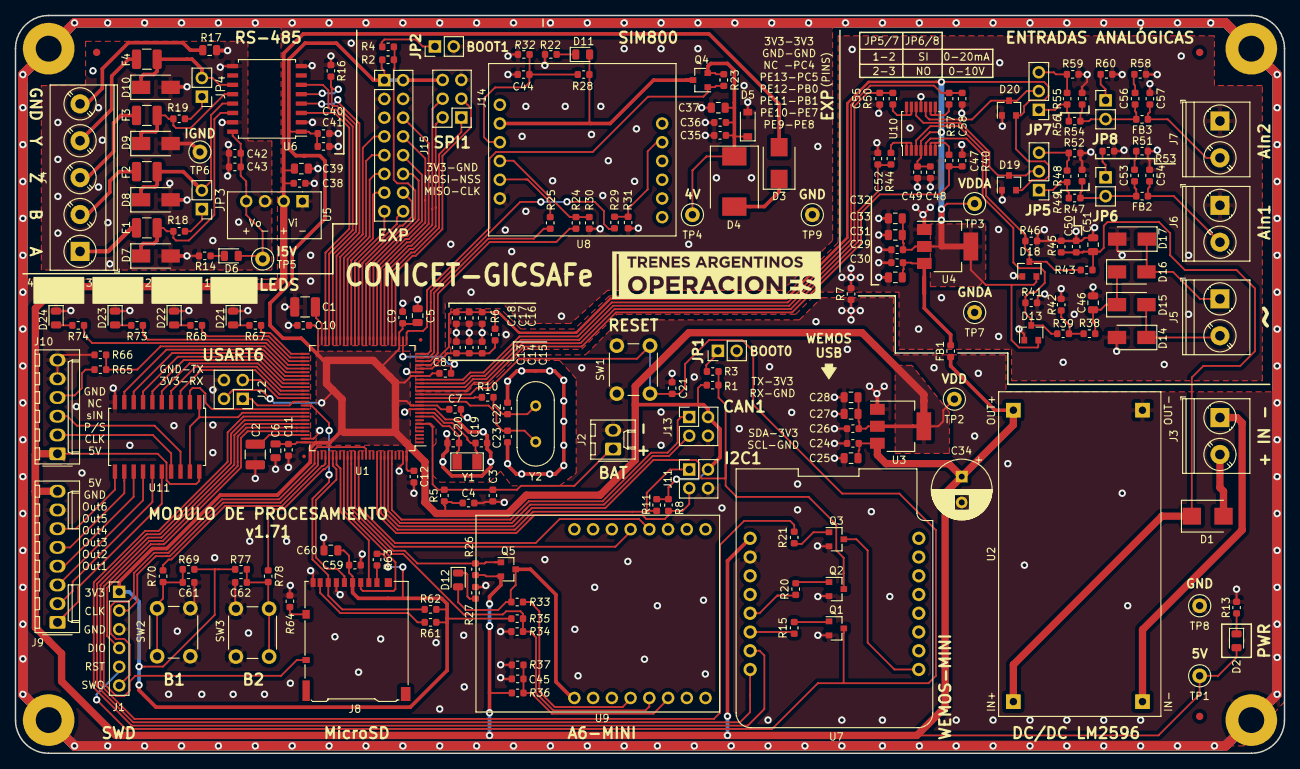
[picture p23: board Placa_base.kicad_pcb from above]

Board: 2 copper layers, 172.0 x 100.0 mm, 228 parts (0 on the bottom side), 162 nets.

Parts:
C1, C2: 2.2uF; C_1210_3225Metric
C3, C15, C17, C40, C42, C48: 1Uf; C_0603_1608Metric
C4, C7, C8, C9, C10, C11, C12, C14, C16, C21, C24, C26, C29, C31, C38, C41, C43, C44, C45, C47, C49, C50, C52, C55, C58, C59, C61, C62: 100nF; C_0603_1608Metric
C5, C6: 4.7uF; C_0805_2012Metric
C13, C18: 10nF; C_0603_1608Metric
C19, C20: 1.5pF; C_0603_1608Metric
C22, C23: 20pF; C_0603_1608Metric
C25, C27, C28, C30, C32, C33, C37, C39, C46, C51, C60: 10uF; C_0805_2012Metric
C34: 820uF 10V; CP_Radial_D8.0mm_P3.50mm
C35: 10p; C_0603_1608Metric
C36: 33p; C_0603_1608Metric
C53, C56: 470pF; C_0603_1608Metric
C54, C57: 1nF; C_0603_1608Metric
D1, D3: S5JB-R5G; D_SMB
D2, D6, D11, D12, D21, D22, D23, D24: LED; LED_0805_2012Metric
D4: B340; D_SMC
D5: BZT52-B5V1X; D_SOD-123
D7, D8, D9, D10: SMAJ12CA-TR; D_SMA
D13, D18, D19, D20: BAV99; SOT-23
D14, D15, D16, D17: MRA4007T3G; D_SMA
F1, F2, F3, F4: USMF020; R_1210_3225Metric
FB1: Ferrite_Bead; R_0603_1608Metric
FB2, FB3: MMZ1608B601C; R_0603_1608Metric
FD1, FD2, FD3: Fiducial; Fiducial_1mm_Dia_2mm_Outer
FD4, FD5: Fiducial; Fiducial_0.5mm_Dia_1mm_Outer
G1: TrenesArgentinosLogo; TrenesArgentinosLogoNeg
H1, H2, H3, H4: MountingHole_Pad; MountingHole_3.5mm_Pad
J1: SWD/STLINK; PinHeader_1x06_P2.54mm_Vertical
J2: Bateria; Molex_KK-254_AE-6410-02A_1x02_P2.54mm_Vertical
J3: Entrada 24V; TerminalBlock_Phoenix_PT-1,5-2-5.0-H_1x02_P5.00mm_Horizonta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
J4: RS-485; TerminalBlock_Phoenix_PT-1,5-5-5.0-H_1x05_P5.00mm_Horizonta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
J5: TV_6V; TerminalBlock_Phoenix_PT-1,5-2-5.0-H_1x02_P5.00mm_Horizonta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
J6: AN1; TerminalBlock_Phoenix_PT-1,5-2-5.0-H_1x02_P5.00mm_Horizonta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
J7: AN2; TerminalBlock_Phoenix_PT-1,5-2-5.0-H_1x02_P5.00mm_Horizonta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
J8: Micro_SD_Card_Det_Hirose_DM3AT; microSD_HC_Hirose_DM3AT-SF-PEJM5
J9: Salidas 5V; Molex_KK-254_AE-6410-08A_1x08_P2.54mm_Vertical
J10: Interfaz con entradas digitales (CD4021); Molex_KK-254_AE-6410-06A_1x06_P2.54mm_Vertical
J11: I2C1; PinHeader_2x02_P2.54mm_Vertical
J12: USART6; PinHeader_2x02_P2.54mm_Vertical
J13: CAN1; PinHeader_2x02_P2.54mm_Vertical
J14: SPI1; PinHeader_2x03_P2.54mm_Vertical
J15: EXP; PinHeader_2x08_P2.54mm_Vertical
JP1, JP2: Jumper_2_Open; PinHeader_1x02_P2.54mm_Vertical
JP3, JP4: Jumper; PinHeader_1x02_P2.54mm_Vertical
JP5, JP7: 1/3-2/3; PinHeader_1x03_P2.54mm_Vertical
JP6, JP8: I_meas; PinHeader_1x02_P2.54mm_Vertical
Q1, Q2, Q3: MMBT3904; SOT-23
Q4, Q5: AO3401; SOT-23
R1, R2: 10K; R_0603_1608Metric
R3, R4: 510; R_0603_1608Metric
R5, R7, R28, R32, R33, R34, R35, R36, R37, R42, R45, R49, R56, R64: 0; R_0603_1608Metric
R6: 47; R_0603_1608Metric
R8, R11: 4K7; R_0603_1608Metric
R10: CALCULAR; R_0603_1608Metric
R13, R14, R22, R27, R70, R78: 1k; R_0603_1608Metric
R15, R20, R21, R24, R25, R29: 1K; R_0603_1608Metric
R16, R30, R31: 5K6; R_0603_1608Metric
R17: 100 1/2W; R_0805_2012Metric
R18, R19: 120; R_0603_1608Metric
R23, R26: 150k; R_0603_1608Metric
R38, R39, R41, R47, R48, R52, R54, R55, R59: 15k; R_0603_1608Metric
R40, R44, R50, R57: 1.5k; R_0603_1608Metric
R43: 47k; R_0603_1608Metric
R46: 12k; R_0603_1608Metric
R51, R58: 4.7; R_0603_1608Metric
R53, R60, R65: 220; R_0603_1608Metric
R61, R62, R63: 56K; R_0603_1608Metric
R66: 330; R_0603_1608Metric
R67, R68, R73, R74: 260; R_0603_1608Metric
R69, R77: 10k; R_0603_1608Metric
SW1, SW2, SW3: SW_Push; SW_PUSH_6mm_H9.5mm
TP1, TP2, TP3, TP4, TP5, TP6, TP7, TP8, TP9: TestPoint; TestPoint_Loop_D2.50mm_Drill1.0mm
U1: STM32F407VGTx; LQFP-100
U2: DC-DC_Step-Down; modulo_dc-dc-LM2596
U3, U4: AZ1117-3.3; SOT-223-3_TabPin2
U5: RFM-0505S; SIP4-RFM0505S
U6: ISO1412; SOIC-16W_7.5x10.3mm_P1.27mm
U7: WeMos_mini; wemos-d1-mini-with-pin-header-and-connector
U8: SIM800L_modulo; SIM800L_mod
U9: Modulo_A6_Mini; Modulo_A6_mini
U10: MCP6L04T-E/ST; TSSOP-14_4.4x5mm_P0.65mm
U11: 74HCT541; SOIC-20W_7.5x12.8mm_P1.27mm
Y1: 32.768KHz; Cristal 32KHz
Y2: 8MHz; Crystal_HC49-4H_Vertical

Connections:
+4V: C35.1, C36.1, C37.1, D4.1, D5.1, Q4.2, R23.2, TP4.1
+5P: C42.1, C43.1, D6.2, TP5.1, U5.4, U6.16
+5V: C24.1, C25.1, C34.1, C38.1, C39.1, D2.2, D3.2, FB1.1, J9.8, J10.1, Q5.2, R26.1, R36.2, TP1.1, U2.3, U3.3, U5.2, U7.1, U11.20
/A6_INT: R34.1, R35.2, U1.84, U9.5
/A6_ON: Q5.1, R26.2, U1.85
/An_In1: C47.1, R40.2, U1.15
/An_In2: C52.1, R44.2, U1.16
/An_In3: C55.1, R50.2, U1.17
/An_In4: C58.1, R57.2, U1.18
/BOOT0: Q2.3, R1.2, R3.1, U1.94
/CAN1_RX: J13.3, U1.95
/CAN1_TX: J13.1, U1.96
/DIO/in_clk: J10.2, U11.17
/DIO/par_ser: J10.3, U11.18
/EXP_PIN1: J15.6, U1.33
/EXP_PIN2: J15.7, U1.44
/EXP_PIN3: J15.8, U1.34
/EXP_PIN4: J15.9, U1.43
/EXP_PIN5: J15.10, U1.35
/EXP_PIN6: J15.11, U1.42
/EXP_PIN7: J15.12, U1.36
/EXP_PIN8: J15.13, U1.41
/EXP_PIN9: J15.14, U1.38
/EXP_PIN10: J15.15, U1.40
/EXP_PIN11: J15.16, U1.39
/I2C1_SCL: J11.3, R8.1, U1.92
/I2C1_SDA: J11.1, R11.1, U1.93
/IN_CLK: U1.62, U11.3
/IN_P-S: U1.66, U11.2
/IN_Read: R65.1, R66.2, U1.55
/LED1: R67.1, U1.51
/LED2: R68.1, U1.52
/LED3: R73.1, U1.53
/LED4: R74.1, U1.54
/MCU/PB2-BOOT1: R2.2, R4.1, U1.37
/MCU/PC14: C20.1, U1.8, Y1.2
/MCU/PC15: C19.1, U1.9, Y1.1
/MCU/PH0: C23.1, U1.12, Y2.2
/MCU/PH1: R10.1, U1.13
/MCU/TCK-SWCLK: J1.2, U1.76
/MCU/TDO-SWO: J1.6, U1.89
/MCU/TMS-SWDIO: J1.4, U1.72
/MCU/VBAT: C3.1, J2.1, R5.2, U1.6
/MCU/VREF+: C13.1, C14.1, C15.1, R6.2, U1.21
/NRST: C21.1, J1.5, Q1.3, SW1.1, U1.14
/OUT_1: U1.61, U11.4
/OUT_2: U1.60, U11.5
/OUT_3: U1.59, U11.6
/OUT_4: U1.58, U11.7
/OUT_5: U1.57, U11.8
/OUT_6: U1.56, U11.9
/OUT_EN: U1.67, U11.1, U11.19
/RS-485_D: U1.47, U6.6
/RS-485_DE: R16.2, U1.46, U6.5
/RS-485_R: U1.48, U6.3
/RS-485_RE: U1.45, U6.4
/Reset_ESP: R21.1, U1.70
/S800_DTR: R29.1, U1.25
/S800_ON: Q4.1, R23.1, U1.26
/SPI1_CK: J14.1, U1.30
/SPI1_MISO: J14.2, U1.31
/SPI1_MOSI: J14.4, U1.32
/SPI1_NSS: J14.3, U1.29
/SW1: R70.2, U1.78
/SW2: R78.2, U1.79
/USART1_RX: U1.69, U7.8
/USART1_TX: U1.68, U7.7
/USART2_RX: U1.87, U9.12
/USART2_TX: U1.86, U9.13
/USART4_RX: R25.1, U1.24
/USART4_TX: R24.1, U1.23
/USART6_RX: J12.1, U1.64
/USART6_TX: J12.3, U1.63
/WiFi/A: D7.1, F1.2, R18.2, U6.14
/WiFi/B: D8.1, F2.2, JP3.2, U6.13
/WiFi/DTR_SIM800: R29.2, R31.2, U8.11
/WiFi/RX_SIM800: R24.2, R30.2, U8.4
/WiFi/TX_SIM800: R25.2, U8.5
/WiFi/Y: D10.1, F4.2, JP4.2, U6.11
/WiFi/Z: D9.1, F3.2, R19.2, U6.12
/analogico/AIn1: C50.1, C51.1, D1.1, R43.1, R45.1, U2.1
/uSD_CD: J8.2, U1.81
/uSD_CK: J8.5, U1.80
/uSD_Cmd: J8.3, U1.83
/uSD_D0: J8.7, R62.1, U1.65
/uSD_Det: J8.10, U1.71
Earth: C42.2, C43.2, D7.2, D8.2, D9.2, D10.2, R14.1, R17.1, TP6.1, U5.3, U6.9, U6.15
GND: C1.2, C2.2, C3.2, C4.2, C5.2, C6.2, C7.2, C8.2, C9.2, C10.2, C11.2, C12.2, C19.2, C20.2, C21.2, C22.2, C23.2, C24.2, C25.2, C26.2, C27.2, C28.2, C34.2, C35.2, C36.2, C37.2, C38.2, C39.2, C40.2, C41.2, C44.2, C45.2, C59.2, C60.2, C61.2, C62.2, D5.2, D21.1, D22.1, D23.1, D24.1, H1.1, H2.1, H3.1, H4.1, J1.3, J2.2, J8.6, J8.9, J9.7, J10.5, J10.6, J11.4, J12.4, J13.4, J14.5, J15.3, J15.4, JP1.2, JP2.2, Q1.2, Q2.2, Q3.2, R7.1, R13.2, R16.1, R22.1, R27.1, R30.1, R31.1, R32.1, R35.1, R37.1, R64.1, R66.1, SW1.2, SW2.2, SW3.2, TP8.1, TP9.1, U1.10, U1.27, U1.74, U1.99, U2.4, U3.1, U5.1, U6.2, U6.8, U7.2, U8.6, U9.14, U11.10
GNDA: C13.2, C14.2, C15.2, C16.2, C17.2, C18.2, C29.2, C30.2, C31.2, C32.2, C33.2, C46.2, C47.2, C48.2, C49.2, C50.2, C51.2, C52.2, C54.2, C55.2, C57.2, C58.2, D13.1, D14.2, D16.2, D18.1, D19.1, D20.1, J6.1, J7.1, R7.2, R41.2, R42.2, R45.2, R46.2, R49.2, R51.1, R52.2, R53.1, R56.2, R58.1, R59.2, R60.1, TP7.1, U1.20, U4.1, U10.11
unnamed: C1.1, U1.49
unnamed: C2.1, U1.73
unnamed: C22.1, R10.2, Y2.1
unnamed: C29.1, C30.1, FB1.2, U4.3
unnamed: C44.1, R28.1, R32.2, U8.3
unnamed: C45.1, R36.1, R37.2, U9.6
unnamed: C46.1, D15.1, D17.1, R38.2
unnamed: C53.1, FB2.2, JP6.2, R47.2, R49.1
unnamed: C53.2, R51.2
unnamed: C54.1, FB2.1, J6.2
unnamed: C56.1, FB3.2, JP8.2, R54.2, R56.1
unnamed: C56.2, R58.2
unnamed: C57.1, FB3.1, J7.2
unnamed: C61.1, R69.1, R70.1, SW2.1
unnamed: C62.1, R77.1, R78.1, SW3.1
unnamed: D1.2, J3.2
unnamed: D2.1, R13.1
unnamed: D3.1, D4.2
unnamed: D6.1, R14.2
unnamed: D11.1, R22.2
unnamed: D11.2, Q4.3, R28.2, U8.2
unnamed: D12.1, R27.2
unnamed: D12.2, Q5.3, R33.1, U9.1
unnamed: D13.3, R39.2, R41.1, U10.5
unnamed: D14.1, D15.2, J5.2
unnamed: D16.1, D17.2, J5.1
unnamed: D18.3, R43.2, R46.1, U10.3
unnamed: D19.3, JP5.2, U10.12
unnamed: D20.3, JP7.2, U10.10
unnamed: D21.2, R67.2
unnamed: D22.2, R68.2
unnamed: D23.2, R73.2
unnamed: D24.2, R74.2
unnamed: F1.1, J4.1
unnamed: F2.1, J4.2
unnamed: F3.1, J4.3
unnamed: F4.1, J4.4
unnamed: J3.1, U2.2
unnamed: J4.5, R17.2
unnamed: J8.1, R63.1
unnamed: J8.8, R61.1
unnamed: J8.11, R64.2
unnamed: J9.1, U11.16
unnamed: J9.2, U11.15
unnamed: J9.3, U11.14
unnamed: J9.4, U11.13
unnamed: J9.5, U11.12
unnamed: J9.6, U11.11
unnamed: J10.4, R65.2
unnamed: JP1.1, R3.2
unnamed: JP2.1, R4.2
unnamed: JP3.1, R18.1
unnamed: JP4.1, R19.1
unnamed: JP5.1, R47.1, R48.1
unnamed: JP5.3, R48.2, R52.1
unnamed: JP6.1, R53.2
unnamed: JP7.1, R54.1, R55.1
unnamed: JP7.3, R55.2, R59.1
unnamed: JP8.1, R60.2
unnamed: Q1.1, R15.1
unnamed: Q2.1, R20.1
unnamed: Q3.1, R21.2
unnamed: Q3.3, U7.9
unnamed: R15.2, U7.6
unnamed: R20.2, U7.5
unnamed: R33.2, U9.4
unnamed: R38.1, R39.1, R42.1
unnamed: R40.1, U10.6, U10.7
unnamed: R44.1, U10.1, U10.2
unnamed: R50.1, U10.13, U10.14
unnamed: R57.1, U10.8, U10.9
VDD: C4.1, C5.1, C6.1, C7.1, C8.1, C9.1, C10.1, C11.1, C12.1, C26.1, C27.1, C28.1, C40.1, C41.1, C59.1, C60.1, J1.1, J8.4, J11.2, J12.2, J13.2, J14.6, J15.1, J15.2, R1.1, R2.1, R5.1, R8.2, R11.2, R34.2, R61.2, R62.2, R63.2, R69.2, R77.2, TP2.1, U1.11, U1.19, U1.28, U1.50, U1.75, U1.100, U3.2, U6.1
VDDA: C16.1, C17.1, C18.1, C31.1, C32.1, C33.1, C48.1, C49.1, D13.2, D18.2, D19.2, D20.2, R6.1, TP3.1, U1.22, U4.2, U10.4
