lucasd92/modulo_adquisidor/CubeMX/CubeMX.ioc

Mcu.UserName=STM32F407VGTx
PA0-WKUP.GPIO_Label=S800_UART4_TX
PA0-WKUP.Signal=UART4_TX
PA1.GPIO_Label=S800_UART4_RX
PA1.Signal=UART4_RX
PA10.GPIO_Label=WIFI_UART1_RX
PA10.Signal=USART1_RX
PA11.GPIO_Label=WIFI_RESET
PA11.Signal=GPIO_Output
PA12.GPIO_Label=SD_DETECT
PA12.Signal=GPIO_Input
PA13.GPIO_Label=SWD_DIO
PA13.Signal=SYS_JTMS-SWDIO
PA14.GPIO_Label=SWD_CLK
PA14.Signal=SYS_JTCK-SWCLK
PA15.GPIO_Label=__FLOATING__
PA15.Signal=GPIO_Analog
PA2.GPIO_Label=S800_UART4_DTR
PA2.Signal=GPIO_Output
PA3.GPIO_Label=S800_ON
PA3.Signal=GPIO_Output
PA4.Signal=SPI1_NSS
PA5.Signal=SPI1_SCK
PA6.Signal=SPI1_MISO
PA7.Signal=SPI1_MOSI
PA8.GPIO_Label=OUT_EN
PA8.Signal=GPIO_Output
PA9.GPIO_Label=WIFI_UART1_TX
PA9.Signal=USART1_TX
PB0.GPIO_Label=EXP_PIN_5
PB0.Signal=GPIO_Output
PB1.GPIO_Label=EXP_PIN_7
PB1.Signal=GPIO_Output
PB10.GPIO_Label=RS485_D_TX
PB10.Signal=USART3_TX
PB11.GPIO_Label=RS485_R_RX
PB11.Signal=USART3_RX
PB12.GPIO_Label=LED_1
PB12.Signal=GPIO_Output
PB13.GPIO_Label=LED_2
PB13.Signal=GPIO_Output
PB14.GPIO_Label=LED_3
PB14.Signal=GPIO_Output
PB15.GPIO_Label=LED_4
PB15.Signal=GPIO_Output
PB2.GPIO_Label=BOOT1
PB2.Signal=GPIO_Input
PB3.GPIO_Label=SWD_SWO
PB3.Signal=SYS_JTDO-SWO
PB4.GPIO_Label=__FLOATING__
PB4.Signal=GPIO_Analog
PB5.GPIO_Label=__FLOATING__
PB5.Signal=GPIO_Analog
PB6.Signal=I2C1_SCL
PB7.Signal=I2C1_SDA
PB8.Signal=CAN1_RX
PB9.Signal=CAN1_TX
PC0.GPIO_Label=ADC1_IN10_An_In1
PC0.Signal=ADCx_IN10
PC1.GPIO_Label=ADC1_IN11_An_In2
PC1.Signal=ADCx_IN11
PC10.GPIO_Label=B1
PC10.Signal=GPIO_Input
PC11.GPIO_Label=B2
PC11.Signal=GPIO_Input
PC12.Signal=SDIO_CK
PC13-ANTI_TAMP.GPIO_Label=__FLOATING__
PC13-ANTI_TAMP.Signal=GPIO_Analog
PC14-OSC32_IN.Signal=RCC_OSC32_IN
PC15-OSC32_OUT.Signal=RCC_OSC32_OUT
PC2.GPIO_Label=ADC1_IN12_An_In3
PC2.Signal=ADCx_IN12
PC3.GPIO_Label=ADC1_IN13_An_In4
PC3.Signal=ADCx_IN13
PC4.GPIO_Label=EXP_PIN_1
PC4.Signal=GPIO_Output
PC5.GPIO_Label=EXP_PIN_3
PC5.Signal=GPIO_Output
PC6.Signal=USART6_TX
PC7.Signal=USART6_RX
PC8.Signal=SDIO_D0
PC9.GPIO_Label=IN_PS
PC9.Signal=GPIO_Output
PD0.GPIO_Label=SD_CD
PD0.Signal=GPIO_Input
PD1.GPIO_Label=__FLOATING__
PD1.Signal=GPIO_Analog
PD10.GPIO_Label=OUT_5
PD10.Signal=GPIO_Output
PD11.GPIO_Label=OUT_4
PD11.Signal=GPIO_Output
PD12.GPIO_Label=OUT_3
PD12.Signal=GPIO_Output
PD13.GPIO_Label=OUT_2
PD13.Signal=GPIO_Output
PD14.GPIO_Label=OUT_1
PD14.Signal=GPIO_Output
PD15.GPIO_Label=IN_CLK
PD15.Signal=GPIO_Output
PD2.Signal=SDIO_CMD
PD3.GPIO_Label=A6_INT
PD3.Signal=GPIO_Output
PD4.GPIO_Label=A6_ON
PD4.Signal=GPIO_Output
PD5.GPIO_Label=A6_UART2_TX
PD5.Signal=USART2_TX
PD6.GPIO_Label=A6_UART2_RX
PD6.Signal=USART2_RX
PD7.GPIO_Label=__FLOATING__
PD7.Signal=GPIO_Analog
PD8.GPIO_Label=IN_READ
PD8.Signal=GPIO_Input
PD9.GPIO_Label=OUT_6
PD9.Signal=GPIO_Output
PE0.GPIO_Label=__FLOATING__
PE0.Signal=GPIO_Analog
PE1.GPIO_Label=__FLOATING__
PE1.Signal=GPIO_Analog
PE10.GPIO_Label=EXP_PIN_8
PE10.Signal=GPIO_Output
PE11.GPIO_Label=EXP_PIN_6
PE11.Signal=GPIO_Output
PE12.GPIO_Label=EXP_PIN_4
PE12.Signal=GPIO_Output
PE13.GPIO_Label=EXP_PIN_2
PE13.Signal=GPIO_Output
PE14.GPIO_Label=RS485_RE
PE14.Signal=GPIO_Output
PE15.GPIO_Label=RS485_DE
PE15.Signal=GPIO_Output
PE2.GPIO_Label=__FLOATING__
PE2.Signal=GPIO_Analog
PE3.GPIO_Label=__FLOATING__
PE3.Signal=GPIO_Analog
PE4.GPIO_Label=__FLOATING__
PE4.Signal=GPIO_Analog
PE5.GPIO_Label=__FLOATING__
PE5.Signal=GPIO_Analog
PE6.GPIO_Label=__FLOATING__
PE6.Signal=GPIO_Analog
PE7.GPIO_Label=EXP_PIN_9
PE7.Signal=GPIO_Output
PE8.GPIO_Label=EXP_PIN_11
PE8.Signal=GPIO_Output
PE9.GPIO_Label=EXP_PIN_10
PE9.Signal=GPIO_Output
PH0-OSC_IN.Signal=RCC_OSC_IN
PH1-OSC_OUT.Signal=RCC_OSC_OUT
