lucasd92/modulo_adquisidor/(commit log)

2019-05-22 v0.11 Primera versión incompleta
    [Alimentacion.sch, DIO.sch, Placa_base.kicad_pcb, Placa_base.sch, WiFi.sch, analogico.sch, mcu.sch]
2019-05-22 V0.11
    Resuelto problema bibliotecas
    [Alimentacion.sch, DIO.sch, WiFi.sch, mcu.sch]
2019-05-27 Selección definitiva de componentes
    Falta interconexión y comunicaciones vacantes.
    [Alimentacion.sch, DIO.sch, Placa_base.sch, WiFi.sch, analogico.sch, mcu.sch]
2019-05-28 v0.14 interconexion completa
    Se terminó de conectar el MCU a los módulos y headers de expansión.
    [Alimentacion.sch, DIO.sch, Expansion.sch, Placa_base.sch, WiFi.sch, analogico.sch, mcu.sch]
2019-05-31 v0.15
    Primera versión de hardware.
    [Alimentacion.sch, DIO.sch, Expansion.sch, Placa_base.kicad_pcb, Placa_base.sch, WiFi.sch, analogico.sch, mcu.sch]
2019-06-04 v0.16
    Correcciones en PCB.
    [Alimentacion.sch, DIO.sch, Expansion.sch, Placa_base.kicad_pcb, Placa_base.sch, WiFi.sch, analogico.sch, mcu.sch]
2019-06-04 v0.17
    Cambios en PCB y nueva versión de PDF.
2019-06-10 Modificaciones en planos de masa
    Se cambiaron algunas pistas y se agregó plano superior junto a vías para mejorar la impedancia.
    [Alimentacion.sch, DIO.sch, Expansion.sch, Placa_base.kicad_pcb, Placa_base.sch, WiFi.sch, analogico.sch, mcu.sch]
2019-07-04 v0.19 pasa ERC con 0 errores/warnings.
    [Alimentacion.sch, DIO.sch, Expansion.sch, Placa_base.kicad_pcb, Placa_base.sch, WiFi.sch, analogico.sch, mcu.sch]
2019-07-05 v0.191
    Cambios de Santiago + dirección etiquetas + CubeMX
    [Alimentacion.sch, DIO.sch, Expansion.sch, Placa_base.sch, WiFi.sch, analogico.sch, mcu.sch]
2019-07-05 Modificaciones en PCB
    [Placa_base.kicad_pcb]
2019-07-09 Importantes mejoras en PCB
    [Alimentacion.sch, DIO.sch, Expansion.sch, Placa_base.kicad_pcb, Placa_base.sch, WiFi.sch, analogico.sch, mcu.sch]
2019-07-10 PCB 1.3. Re-ruteo de 5v, VCC, desacople, etc.
    [DIO.sch, Placa_base.kicad_pcb]
2019-07-10 Se corrige ruteo de pads en U11
    [Placa_base.kicad_pcb]
2019-07-11 Cambio de I2C3 por USART6
    Cambio mínimo para que quede disponible la UART6
    [Alimentacion.sch, DIO.sch, Expansion.sch, Placa_base.kicad_pcb, Placa_base.sch, WiFi.sch, analogico.sch, mcu.sch]
2019-07-12 Modificaciones menores en esquemático y PCB
    Se reemplazó I2C3 por USART6 (debug), se agregaron pull-ups en I2C1, reducción de agujeros de vías a 0.5mm y actualización de labels en esquemático.
    [Alimentacion.sch, DIO.sch, Expansion.sch, Placa_base.kicad_pcb, Placa_base.sch, WiFi.sch, analogico.sch, mcu.sch]
2019-07-15 Reemplazo de todos los footprints
    Se reemplazaron todos los footprints para hacer soldadura por horno y se acomodó nuevamente la serigrafía.
    [Alimentacion.sch, DIO.sch, Expansion.sch, Placa_base.kicad_pcb, Placa_base.sch, WiFi.sch, analogico.sch, mcu.sch]
2019-07-16 Cambios para reducir PCB
    Cambio de nodemcu por wemos y ajuste de todas las pistas
    [Placa_base.kicad_pcb, WiFi.sch]
2019-07-16 Continuo con la reducción
    conecté las pistas faltantes, resta reducir los márgenes y planos de masa.
    [Placa_base.kicad_pcb]
2019-07-17 Cambio de nodemcu a wemos y reducción
    Se finalizó la reducción del PCB junto con el reemplazo del nodemcu por wemos d1 mini.
    [Alimentacion.sch, DIO.sch, Expansion.sch, Placa_base.kicad_pcb, Placa_base.sch, WiFi.sch, analogico.sch, mcu.sch]
2019-07-31 PCB v1.5
    [Placa_base.kicad_pcb]
2019-08-02 PCB v1.51
    Agregado de Test-point, fiduciales y modelos 3D.
    [Alimentacion.sch, DIO.sch, Expansion.sch, Placa_base.kicad_pcb, Placa_base.sch, WiFi.sch, analogico.sch, mcu.sch]
2019-08-02 PCB v1.51
    Actualización de comentarios.
2019-08-02 PCB 1.6. Optimizacion de 4V. Correccion de overlap entre impresiones de componentes.
    [Placa_base.kicad_pcb]
2019-08-04 PCB 1.61: nombre de la placa y version
    [Placa_base.kicad_pcb]
2019-08-06 PCB 1.62: serigrafía pines J10
    Actualización de PDF y cambios mínimos.
    [Alimentacion.sch, DIO.sch, Expansion.sch, Placa_base.kicad_pcb, Placa_base.sch, WiFi.sch, analogico.sch, mcu.sch]
2019-08-06 PCB v1.62: Cambio de nombre
    Cambio de nombre a Módulo de procesamiento y versión a v1.62.
    [Placa_base.kicad_pcb]
2019-08-07 Agregado de BOM
    [BOM.xlsx]
2019-08-15 BOM actualizada
    Se adaptó la BOM a un formato que pueda leer digikey,
    [BOM.xlsx, Placa_base.kicad_pcb]
2019-08-30 PCB 1.7
    [Placa_base.kicad_pcb]
2019-09-14 PCB 1.71
    [Alimentacion.sch, DIO.sch, ECS-.327-12.5-34B-C-TR--3DModel-STEP-40055.STEP, Expansion.sch, Placa_base.kicad_pcb, Placa_base.sch, WiFi.sch, analogico.sch]
